SoponSaenkaew/fall-detection/docs/assembly_small.jpg

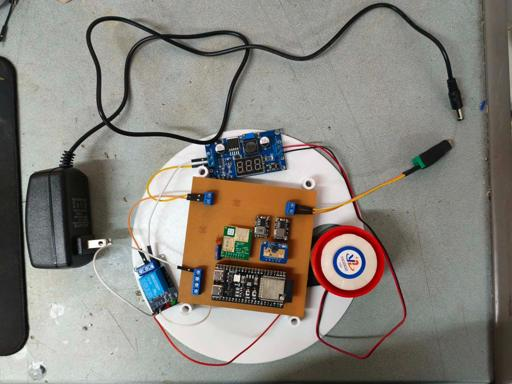
docs/assembly_small.jpg
