SoponSaenkaew/fall-detection/docs/3D print/Brilliant Amberis (3).stl

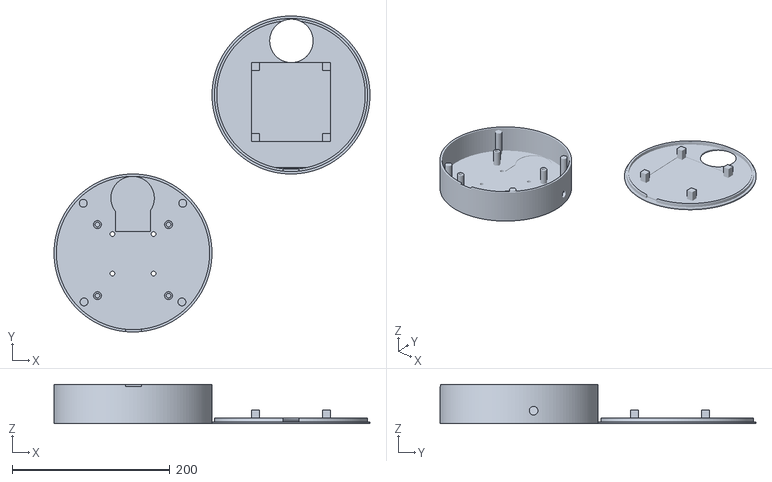
[picture p2: CAD file, 2026-09-25]
docs/3D print/Brilliant Amberis (3).stl
400.0 x 400.0 x 50.0
