SoponSaenkaew/fall-detection/docs/project_guide.html

60 GHz mmWave Radar & Cloud Native IoT Architecture

# ระบบตรวจจับการล้มอัจฉริยะในห้องน้ำ SafeBathroom IoT System Master Guide

คู่มือเจาะลึก 10 มิติสำคัญ: สถาปัตยกรรมระดับฮาร์ดแวร์, ตาราง Pinout, โปรโตคอลเรดาร์ LD6002C, กลไก Sensor Fusion, MQTT LWT, โครงสร้างฐานข้อมูล PostgreSQL, โค้ดหลังบ้าน Go, หน้าบ้าน Next.js, คลาวด์ Azure VM และคลังคำถามกรรมการ

ชิปประมวลผล

ESP32-S3

Xtensa Dual-core 240MHz + NVS

เรดาร์คลื่นมิลลิเมตร

60 GHz & 24 GHz

LD6002C (FMCW) + LD2410C

เซิร์ฟเวอร์คลาวด์

Go + Azure VM

Docker + Mosquitto + Postgres

ระบบเตือนภัย

LINE & Siren

Silent Timer + Web Audio API

สารบัญหัวข้อ (10 ส่วน)

1

## ภาพรวมสถาปัตยกรรมระดับระบบ (System Architecture & Pipeline)

ที่มาของปัญหา ความสำคัญ และการไหลของข้อมูลตั้งแต่เซนเซอร์จนถึงผู้ดูแลระบบ

### ทำไมต้องเป็น "ห้องน้ำ" และทำไมเทคโนโลยีอื่นจึงล้มเหลว?

ข้อจำกัดของเทคโนโลยีเดิม

- • กล้องวงจรปิด (Cameras): ผิดกฎหมายคุ้มครองข้อมูลส่วนบุคคล (PDPA/Privacy) อย่างร้ายแรง จึงไม่สามารถติดในห้องน้ำได้เด็ดขาด
- • เซนเซอร์ความร้อน PIR: ตรวจจับได้เฉพาะคนเคลื่อนไหว หากคนล้มหมดสติหรือนอนนิ่ง PIR จะตีความว่า "ห้องว่าง" ทันที
- • นาฬิกา/ปุ่มกดฉุกเฉิน (Wearables): ผู้สูงอายุมักถอดออกก่อนอาบน้ำ และหากล้มจนหมดสติจะไม่สามารถกดปุ่มได้
- • ความชื้นและละอองน้ำ: อุปกรณ์เลนส์ออปติคอลมักมีฝ้าไอน้ำเกาะ ทำให้จับภาพไม่ได้

จุดเด่นของ SafeBathroom IoT

- • ความเป็นส่วนตัว 100%: คลื่นวิทยุเรดาร์วัดแค่ค่าสะท้อนสนามคลื่นแม่เหล็กไฟฟ้า (Point Cloud) ไม่มีภาพถ่ายแม้แต่พิกเซลเดียว
- • ตรวจจับคนหมดสติได้: มีคลื่น 24GHz ตรวจจับการกระเพื่อมของหน้าอกจากการหายใจ (Micro-motion)
- • ทนทานต่อสภาพแวดล้อม: คลื่น 60GHz ทะลุไอน้ำ ละอองน้ำ และทำงานได้แม้ปิดไฟมืดสนิท 0 Lux
- • Zero-touch: ติดตั้งบนเพดาน ผู้ใช้งานไม่ต้องพกพาอุปกรณ์ ไม่ต้องกดปุ่มใดๆ

สถาปัตยกรรมการเชื่อมต่อแบบ End-to-End Pipeline Real-time < 500ms

1. Sensing

LD6002C + LD2410C

เรดาร์ 60GHz + 24GHz บนเพดานห้องน้ำ

2. Edge Processing

ESP32-S3 Firmware

Sensor Fusion, จับเวลาอยู่นาน, ไซเรน

3. Transport Layer

MQTT + LWT

Mosquitto Broker บน Azure Docker

4. Cloud Engine

Go Backend (Gin)

บันทึก PostgreSQL, ยิง LINE Notify

5. Frontend Client

Next.js Dashboard

WebSocket Live Feed + เสียงไซเรนเตือน

2

## วงจรฮาร์ดแวร์และตาราง Pinout (Hardware Schematics & Pinout)

รายละเอียดขา GPIO แรงดันไฟฟ้า วงจรรีเลย์ และปุ่มจำลองบนบอร์ด ESP32-S3

ESP32 Pin | อุปกรณ์ที่เชื่อมต่อ | ชนิดสัญญาณ (Mode) | โปรโตคอล / ระดับลอจิก | หน้าที่การทำงาน
GPIO 18 | HLK-LD6002C (TX Pin) | Digital INPUT (RX0) | UART 115200 Baud | รับ Binary Frames ตรวจจับคนหกล้มและพิกัด
GPIO 17 | HLK-LD6002C (RX Pin) | Digital OUTPUT (TX0) | UART 115200 Baud | ส่งคำสั่ง Config / Reset สู่โมดูล LD6002C
GPIO 16 | HLK-LD2410C (OUT Pin) | INPUT_PULLDOWN | Active HIGH (3.3V) | ตรวจสอบการมีคนอยู่ในห้อง (HIGH=มีคน, LOW=ห้องว่าง)
GPIO 15 | Relay Module + Buzzer | OUTPUT | Active LOW (0V=ดัง) | ขับเสียงไซเรนฉุกเฉินเมื่อเกิดเหตุล้ม (LOW=สับสวิตช์)
GPIO 48 | WS2812B RGB LED | OUTPUT | NeoPixel 800kHz Single-wire | ไฟบอกสถานะ (เขียว=ว่าง, น้ำเงิน=มีคน, แดง=ล้ม, ส้ม=อยู่นาน)
GPIO 4 | Button: Sim Fall | INPUT_PULLUP | Active LOW (กดปุ่ม) | ปุ่มทดสอบบนบอร์ด: บังคับเกิดเหตุล้มทันทีเพื่อสาธิต
GPIO 5 | Button: Sim Enter | INPUT_PULLUP | Active LOW (กดปุ่ม) | ปุ่มทดสอบบนบอร์ด: บังคับสถานะมีคนเข้าห้องน้ำ
GPIO 1 | Button: Sim Exit | INPUT_PULLUP | Active LOW (กดปุ่ม) | ปุ่มทดสอบบนบอร์ด: บังคับสถานะคนออกจากห้องน้ำ
5V & GND | Power Supply Rails | Power Input | DC 5V / 2A Step-Down | จ่ายไฟเลี้ยงเรดาร์ LD6002C, โมดูลรีเลย์ไซเรน และบอร์ด ESP32

#### ระบบจ่ายไฟและความเสถียร (Power Architecture)

เซนเซอร์เรดาร์ 60 GHz (LD6002C) มีช่วงพีคกระแสส่งคลื่นความถี่สูงถึง 400-500 mA การต่อไฟตรงจากขา 3.3V ของบอร์ดไมโครคอนโทรลเลอร์จะทำให้เกิดแรงดันตก (Voltage Drop) และทำให้บอร์ดรีสตาร์ทตัวเอง เราจึงใช้แหล่งจ่ายไฟ 5V 2A ภายนอก แยกรางจ่ายให้กับเรดาร์และรีเลย์โดยตรง พร้อมต่อ C ฟิลเตอร์ 100uF คร่อม VCC/GND

#### วงจรรีเลย์ Active LOW สำหรับไซเรน

โมดูลรีเลย์ที่ใช้เป็นแบบ Active LOW กล่าวคือเมื่อขา GPIO 15 จ่ายแรงดัน 0V (LOW) ทรานซิสเตอร์ออปโต้จะนำกระแส ทำให้ขดลวดรีเลย์สับสวิตช์ส่งเสียงไซเรน และเมื่อจ่าย HIGH (3.3V) รีเลย์จะตัดวงจร ดังนั้นในโค้ดฟังก์ชัน setup() จึงต้องสั่ง digitalWrite(RELAY_BUZZER_PIN, HIGH) ก่อนเสมอ เพื่อป้องกันเสียงดังรบกวนขณะเปิดเครื่อง

3

## เจาะลึกโปรโตคอลเรดาร์ (Radar Protocols: LD6002C & LD2410C)

โครงสร้าง Binary Frame การคำนวณ Checksum และการประมวลผลข้อมูลระดับไบต์

### HLK-LD6002C โครงสร้างเฟรมข้อมูล Binary (UART 115200 Baudrate)

เรดาร์ส่งข้อมูลเป็น Binary Stream ความเร็วสูง โดยแต่ละแพ็กเก็ตมีความยาวแปรผัน แต่มีโครงสร้างคงที่ 8 ไบต์แรก:

SOF (1B)

0x01

Start Byte

ID (1B)

0xXX

Radar ID

LEN (2B)

0x00 0x08

Length (Little)

TYPE (2B)

0x0E02

Fall Event

PAYLOAD (N)

0x01 ...

State / Point

CHKSUM (1B)

~XOR

Bitwise Invert

รหัสชนิดข้อความ (Message Types) ตามคู่มือทางการ HLK-LD6002C Communication Protocol: TinyFrame Standard

0x0E02 : MSG_IND_FALL_STATUS Radar → MCU

รายงานผลตรวจจับการล้ม: Payload 1 ไบต์ (0x01 = หกล้ม, 0x00 = ท่าทางปกติ)

0x0E0C : MSG_IND_FALL_SET_ALARM_AREA Two-way (16 Bytes)

กำหนดขอบเขตพื้นที่เตือนภัย / ขนาดห้อง: ส่ง Float 4 ค่า (rect_XL ซ้าย, rect_XR ขวา, rect_ZF หน้า, rect_ZB หลัง)

0x0E04 : MSG_IND_FALL_SET_HIGH Two-way (4 Bytes)

ตั้งค่าความสูงติดตั้งเรดาร์จากพื้น: ส่ง Float 4 ไบต์ (ระยะ 1.0 - 5.0 เมตร เช่น 2.2m) และเรดาร์ตอบรับ ACK (0=fail, 1=success)

0x0E08 : MSG_IND_FALL_SET_THRESHOLD Two-way (4 Bytes)

ตั้งค่าเกณฑ์ความสูงตัดสินการล้ม (Fall Threshold): Float 4 ไบต์ (ค่าเริ่มต้น 0.6m หรือปรับตั้ง 0.5m) และเรดาร์ตอบรับผล

0x0E0E : MSG_TARGET_HEIGHT Radar → MCU (Live)

รายงานระดับความสูงสดของเป้าหมาย: เรดาร์ส่งระดับความสูงของเป้าหมายจากพื้นแบบอัตโนมัติ (Float 4 ไบต์)

0x0E06 / 0x0E0A : GET_HIGH & SENSITIVITY Config Commands

0x0E06 อ่านค่าพารามิเตอร์ทั้งหมด 28 ไบต์ | 0x0E0A ตั้งค่าความไวตรวจจับ (3~10 เฟรม)

โค้ดการคำนวณ Checksum และถอดรหัสใน RadarSensors.h: ESP32 Firmware

// สูตรคำนวณ Checksum ของ LD6002C: Bitwise Invert of XOR sum (~XOR)
uint8_t calcXor = 0;
for (int i = 0; i < frameLen - 1; i++) {
    calcXor ^= buffer[i];
}
uint8_t expectedChecksum = ~calcXor; // กลับบิตทั้งหมด

if (buffer[frameLen - 1] == expectedChecksum) {
    uint16_t msgType = (buffer[4] << 8) | buffer[5];
    if (msgType == 0x0E02) { // เฟรมตรวจจับการล้ม
        uint8_t isFall = buffer[6]; // ไบต์แรกของ Payload
        if (isFall == 0x01 && current_event != "exit") {
            triggerFallEvent(); // ยืนยันการล้ม (Sensor Fusion Guard)
        }
    }
}

4

## ตรรกะการผสานข้อมูลเซนเซอร์ (Sensor Fusion & Edge State Machine)

อัลกอริทึมกรอง False Alarm, ระบบฟื้นตัวอัตโนมัติ (Recovery) และหน่วยความจำ NVS Flash

จุดอ่อนของระบบที่ใช้เรดาร์ตัวเดียวคือ False Alarm จากสิ่งของตกหล่น เช่น หากขวดแชมพูหรือผ้าเช็ดตัวร่วงหล่นลงพื้น คลื่นความถี่ 60GHz อาจตีความว่าเกิดการตกกระทบของมวล (Fall) ดังนั้นเราจึงออกแบบกลไก Sensor Fusion ข้ามย่านความถี่:

#### 1. Empty Room Guard

แม้ LD6002C จะยิงเฟรม 0x0E02 (Fall) ออกมา แต่เฟิร์มแวร์จะไม่ประมวลผล หาก LD2410C รายงานว่าห้องว่าง (ขา OUT เป็น LOW) ทำให้ตัดปัญหาสิ่งของตกในห้องน้ำที่ไม่มีคนได้อย่างเด็ดขาด 100%

#### 2. Fall Recovery & Failsafe

Auto Recovery: หากคนล้มแล้วพยุงตัวลุกขึ้นยืนทรงตัวได้เกิน 2.5 วินาที ระบบจะปรับจาก fall คืนสู่ enter
Failsafe: หากค้างสถานะล้มแต่คนเดินออกไปแล้วเกิน 20 วินาที จะตัดเข้า exit

#### 3. Prolonged Stay (อยู่นาน)

เมื่อมีคนเข้าห้องน้ำ ตัวนับเวลาจะเริ่มเดิน หากอยู่ต่อเนื่องเกินเวลาที่ตั้งไว้ (ดีฟอลต์ 30 นาที) บอร์ดจะส่งเตือน prolonged_stay โดยปิดเสียงไซเรน (Silent Alert) เพื่อเคารพความเป็นส่วนตัวและไม่รบกวนผู้สูงอายุ

State (สถานะ) | เงื่อนไขเซนเซอร์ | ไฟ LED (WS2812B) | รีเลย์ไซเรน (Relay) | การแจ้งเตือนทาง LINE
exit ห้องว่าง | LD2410 OUT = LOW (> 5 วินาที) | 🟢 เขียวนิ่ง (Green) | OFF (ขา 15 = HIGH) | - ไม่ส่ง -
enter มีคนใช้งาน | LD2410 OUT = HIGH (ตรวจพบคน) | 🔵 ฟ้านิ่ง (Blue) | OFF (ขา 15 = HIGH) | - ไม่ส่ง -
fall คนล้มฉุกเฉิน! | มีคน + LD6002C Frame 0x0E02 | 🔴 แดงกะพริบถี่ (Blink Red) | 🔊 ON ดังต่อเนื่อง (ขา 15 = LOW) | 🚨 แจ้งเหตุฉุกเฉินทันที!
prolonged_stay อยู่นานเกิน | สถานะ enter ต่อเนื่อง ≥ timeout | 🟠 ส้มนิ่ง (Orange) | OFF (ปิดเสียงเพื่อความเป็นส่วนตัว) | ⏳ ส่งแจ้งเตือนเคาะประตูห้อง
offline ขาดการเชื่อมต่อ | MQTT Heartbeat ขาด / ไฟดับ (LWT) | - (ตัวเครื่องดับ) | - | การ์ดแสดงสถานะสีเทาบนแดชบอร์ด

การบันทึกค่าลง Non-Volatile Storage (NVS Flash Memory)

เมื่อผู้ดูแลตั้งค่าความสูงเพดาน (Mount Height) หรือเวลาเตือนอยู่นาน (Stay Timeout) จากหน้าแดชบอร์ด ข้อมูลจะถูกส่งลงบอร์ดผ่าน MQTT และเซฟลงชิป ESP32 NVS Flash ทันที เมื่อไฟดับหรือดึงปลั๊กออก ค่าคอนฟิกเหล่านี้จะไม่สูญหาย และบอร์ดจะนำมาใช้ทำงานต่อได้ทันทีที่ไฟมา

5

## โปรโตคอลการสื่อสาร MQTT, JSON Payload และกลไก LWT

การออกแบบ Topic, โครงสร้างข้อมูล JSON และการตรวจจับเครื่องดับฉับพลันด้วยพินัยกรรม

#### โครงสร้าง Topic ในระบบ

- sensor/events
  บอร์ดส่ง Event ขึ้น Backend (fall, enter, exit, stay)
- sensor/settings
  Backend ส่งคำสั่งปรับพารามิเตอร์ลงบอร์ด (Remote Config)

การใช้ MQTT QoS 0 ทำให้การส่งข้อมูลมี Overhead ต่ำเป็นพิเศษ (ไม่เกิน 200 ไบต์ต่อแพ็กเก็ต) รองรับการรับส่งผ่านเครือข่าย Wi-Fi ที่สัญญาณอ่อนในมุมอับของห้องน้ำได้ดี

#### ตัวอย่าง JSON Payload มาตรฐาน

{
  "device_id": "B1_R101",
  "type": "event",
  "name": "fall",
  "value": "ตรวจพบคนล้ม (เรดาร์)",
  "metadata": "{\"x\":1.2,\"y\":2.4,\"z\":0.3}"
}

#### ขั้นตอนการทำงานของ MQTT Last Will & Testament (LWT)

ขั้นตอนที่ 1

ฝากพินัยกรรม

ตอนบอร์ด Connect ระบุ Will Payload เป็น {"name":"offline"}

ขั้นตอนที่ 2

ส่ง Heartbeat ปกติ

บอร์ดแลกเปลี่ยน Ping กับ Mosquitto ตลอดเวลา

ขั้นตอนที่ 3

ไฟดับ / เครื่องดับ

TCP Socket ขาดสะบั้น โดยไม่มีการส่งแพ็กเก็ต DISCONNECT

ขั้นตอนที่ 4

โบรกเกอร์เปิดพินัยกรรม

Mosquitto เผยแพร่ข้อความ offline ไปให้ Go Backend ทันที

6

## สถาปัตยกรรมฐานข้อมูลเชิงสัมพันธ์และสกีม่า (Database Schemas & Architecture Rationale)

โครงสร้างสกีม่าทั้ง 6 ตาราง, ความหมายทุกคอลัมน์, ข้อกำหนดความสมบูรณ์ของข้อมูล และเหตุผลเชิงวิศวกรรมในการออกแบบ

### Azure Database for PostgreSQL (Flexible Server)

ระบบจัดการฐานข้อมูลเชิงสัมพันธ์ระดับ Enterprise: Flexible Server B1ms (1 vCPU, 2 GiB RAM), Port 5432, บังคับใช้ SSL Mode (sslmode=require)

PostgreSQL 15+ GORM AutoMigrate Native JSONB Soft Delete Enabled

#### 1. แผนผังความสัมพันธ์ข้อมูลระดับภาพรวม (Entity-Relationship Model)

Primary Parent

👤 USERS

ผู้ดูแลระบบ/ผู้ใช้

PK: id

1 : N from Users

🏢 GROUPS

อาคาร / วอร์ด / โซน

PK: id | FK: user_id

1 : N from Groups

🚪 DEVICES

ห้องน้ำ / กล่องเซนเซอร์

PK: id | FK: group_id

1 : N from Devices

📜 DEVICE_EVENTS

ประวัติเหตุการณ์ฉุกเฉิน

PK: id | FK: device_id

DEVICES (1) ➔ DEVICE_SETTINGS (1) 1:1 Strict

แยกพารามิเตอร์ฮาร์ดแวร์เรดาร์ (เกณฑ์ล้ม, ความสูง, เวลาอยู่นาน) ออกจากสถานะสด

GROUPS (1) ➔ NOTIFICATION_CONFIGS (N) 1:N Flexible

ผูกช่องทางเตือนภัย LINE Bot / Webhook เข้ากับอาคารหรือวอร์ดโดยตรง

#### 2. สกีม่าของระบบฉบับสมบูรณ์ (Complete Schema Definitions)

PostgreSQL DDL Go GORM Structs

-- =========================================================================
-- 1. ตาราง users: เก็บข้อมูลบัญชีผู้ดูแลระบบ (Admin Authentication)
-- =========================================================================
CREATE TABLE users (
    id          BIGSERIAL PRIMARY KEY,
    created_at  TIMESTAMPTZ DEFAULT CURRENT_TIMESTAMP,
    updated_at  TIMESTAMPTZ DEFAULT CURRENT_TIMESTAMP,
    deleted_at  TIMESTAMPTZ,                           -- สำหรับ GORM Soft Delete
    username    VARCHAR(255) NOT NULL UNIQUE,
    email       VARCHAR(255) NOT NULL UNIQUE,
    password    VARCHAR(255) NOT NULL,                  -- เก็บรหัสผ่านแบบ Bcrypt Hash
    role        VARCHAR(50)  DEFAULT 'admin'
);
CREATE INDEX idx_users_deleted_at ON users(deleted_at);

-- =========================================================================
-- 2. ตาราง groups: โครงสร้างอาคาร / แผนก / โซนที่ติดตั้ง (Multi-tenancy)
-- =========================================================================
CREATE TABLE groups (
    id          BIGSERIAL PRIMARY KEY,
    created_at  TIMESTAMPTZ DEFAULT CURRENT_TIMESTAMP,
    updated_at  TIMESTAMPTZ DEFAULT CURRENT_TIMESTAMP,
    deleted_at  TIMESTAMPTZ,
    name        VARCHAR(255) NOT NULL,                 -- ชื่ออาคาร เช่น "อาคารผู้ป่วยพิเศษ 1"
    description TEXT,                                  -- คำบรรยายสถานที่
    address     TEXT,
    user_id     BIGINT REFERENCES users(id) ON DELETE SET NULL
);
CREATE INDEX idx_groups_deleted_at ON groups(deleted_at);
CREATE INDEX idx_groups_user_id ON groups(user_id);

-- =========================================================================
-- 3. ตาราง devices: กล่องเซนเซอร์ประจำห้องน้ำแต่ละห้อง (Hardware Registration)
-- =========================================================================
CREATE TABLE devices (
    id                    BIGSERIAL PRIMARY KEY,
    created_at            TIMESTAMPTZ DEFAULT CURRENT_TIMESTAMP,
    updated_at            TIMESTAMPTZ DEFAULT CURRENT_TIMESTAMP,
    deleted_at            TIMESTAMPTZ,
    device_id             VARCHAR(100) NOT NULL UNIQUE,   -- Hardware ID เช่น "B1_R101"
    name                  VARCHAR(255),                   -- ชื่อห้อง เช่น "ห้องน้ำชาย 101"
    room_number           VARCHAR(50),
    status                VARCHAR(50) DEFAULT 'offline', -- "online" หรือ "offline"
    latest_event          VARCHAR(50),                    -- "fall", "enter", "exit", "prolonged_stay"
    latest_event_metadata TEXT,                           -- ข้อมูลล่าสุดในรูปแบบ JSON String
    group_id              BIGINT REFERENCES groups(id) ON DELETE CASCADE
);
CREATE INDEX idx_devices_deleted_at ON devices(deleted_at);
CREATE INDEX idx_devices_device_id ON devices(device_id);
CREATE INDEX idx_devices_group_id ON devices(group_id);

-- =========================================================================
-- 4. ตาราง device_events: เก็บบันทึกประวัติทุกเหตุการณ์ (Event Logging & Audit)
-- =========================================================================
CREATE TABLE device_events (
    id              BIGSERIAL PRIMARY KEY,
    created_at      TIMESTAMPTZ DEFAULT CURRENT_TIMESTAMP,
    updated_at      TIMESTAMPTZ DEFAULT CURRENT_TIMESTAMP,
    deleted_at      TIMESTAMPTZ,
    device_id       BIGINT NOT NULL REFERENCES devices(id) ON DELETE CASCADE,
    type            VARCHAR(50) NOT NULL,              -- "event" (ล้ม/เข้า/ออก) หรือ "status" (เน็ต)
    name            VARCHAR(50) NOT NULL,              -- "fall", "prolonged_stay", "enter", "exit"
    value           TEXT,                              -- คำอธิบายเหตุการณ์ เช่น "ตรวจพบคนล้ม"
    metadata        JSONB,                             -- พิกัด X, Y, Z หรือ Payload ยืดหยุ่น
    status          VARCHAR(50) DEFAULT 'pending',  -- "pending", "resolved", "false_alarm", "normal"
    resolved_at     TIMESTAMPTZ,                       -- เวลาที่เจ้าหน้าที่กดบันทึกผลการเข้าช่วย
    resolved_by     VARCHAR(255),                      -- ชื่อเจ้าหน้าที่/พยาบาลเวร
    resolution_note TEXT                               -- บันทึกอาการ เช่น "นำส่งห้องฉุกเฉินแล้ว"
);
CREATE INDEX idx_device_events_deleted_at ON device_events(deleted_at);
CREATE INDEX idx_device_events_device_id ON device_events(device_id);
CREATE INDEX idx_device_events_status ON device_events(status);
CREATE INDEX idx_device_events_created_at ON device_events(created_at DESC);

-- =========================================================================
-- 5. ตาราง device_settings: พารามิเตอร์ฮาร์ดแวร์เรดาร์ (1:1 กับ Devices)
-- =========================================================================
CREATE TABLE device_settings (
    id                   BIGSERIAL PRIMARY KEY,
    created_at           TIMESTAMPTZ DEFAULT CURRENT_TIMESTAMP,
    updated_at           TIMESTAMPTZ DEFAULT CURRENT_TIMESTAMP,
    deleted_at           TIMESTAMPTZ,
    device_id            VARCHAR(100) NOT NULL UNIQUE REFERENCES devices(device_id) ON DELETE CASCADE,
    fall_threshold       DOUBLE PRECISION DEFAULT 0.5,     -- เกณฑ์ตัดสินล้ม (เมตร)
    mount_height         DOUBLE PRECISION DEFAULT 2.0,     -- ความสูงติดตั้งเพดาน (เมตร)
    room_width           DOUBLE PRECISION DEFAULT 4.0,     -- ความกว้างห้อง (เมตร)
    room_length          DOUBLE PRECISION DEFAULT 4.0,     -- ความยาวห้อง (เมตร)
    stay_timeout_minutes DOUBLE PRECISION DEFAULT 30.0    -- เวลาอยู่นานเกินเตือนเงียบ (นาที)
);
CREATE INDEX idx_device_settings_device_id ON device_settings(device_id);

-- =========================================================================
-- 6. ตาราง notification_configs: ช่องทางแจ้งเตือนฉุกเฉิน (1:N กับ Groups)
-- =========================================================================
CREATE TABLE notification_configs (
    id            BIGSERIAL PRIMARY KEY,
    created_at    TIMESTAMPTZ DEFAULT CURRENT_TIMESTAMP,
    updated_at    TIMESTAMPTZ DEFAULT CURRENT_TIMESTAMP,
    deleted_at    TIMESTAMPTZ,
    group_id      BIGINT REFERENCES groups(id) ON DELETE CASCADE,
    type          VARCHAR(50) NOT NULL DEFAULT 'line', -- "line", "discord", "webhook"
    target_url    TEXT,                                     -- Endpoint ปลายทาง Webhook
    line_token    TEXT,                                     -- LINE Channel Access Token
    line_group_id VARCHAR(100),                             -- Group ID แชทพยาบาล
    enabled       BOOLEAN DEFAULT TRUE
);
CREATE INDEX idx_notification_configs_group_id ON notification_configs(group_id);

// backend/internal/user/model.go & backend/internal/iot/model.go
package iot

import (
    "time"
    "gorm.io/gorm"
)

// 1. User: ผู้ดูแลระบบ
type User struct {
    gorm.Model
    Email    string  `gorm:"unique;not null" json:"email"`
    Username string  `gorm:"unique;not null" json:"username"`
    Password string  `gorm:"not null" json:"-"` // ซ่อน password จาก JSON Response
    Role     string  `gorm:"default:'admin'" json:"role"`
    Groups   []Group `gorm:"foreignKey:UserID" json:"groups,omitempty"`
}

// 2. Group: อาคาร / โซน
type Group struct {
    gorm.Model
    Name                string               `gorm:"not null" json:"name"`
    Description         string               `json:"description"`
    Address             string               `json:"address"`
    UserID              uint                 `json:"user_id"`
    Devices             []Device             `gorm:"foreignKey:GroupID" json:"devices"`
    NotificationConfigs []NotificationConfig `gorm:"foreignKey:GroupID" json:"notification_configs"`
}

// 3. Device: ห้องน้ำแต่ละจุด
type Device struct {
    gorm.Model
    DeviceID            string        `gorm:"unique;not null" json:"device_id"`
    Name                string        `json:"name"`
    RoomNumber          string        `json:"room_number"`
    Status              string        `gorm:"default:'offline'" json:"status"`
    LatestEvent         string        `json:"latest_event"`
    LatestEventMetadata string        `json:"latest_event_metadata"`
    GroupID             uint          `json:"group_id"`
    Settings            DeviceSetting `gorm:"foreignKey:DeviceID;references:DeviceID" json:"settings"`
    Events              []DeviceEvent `gorm:"foreignKey:DeviceID" json:"events,omitempty"`
}

// 4. DeviceEvent: ประวัติเหตุการณ์
type DeviceEvent struct {
    gorm.Model
    DeviceID       uint       `gorm:"index;not null" json:"device_id"`
    Type           string     `gorm:"index;not null" json:"type"`
    Name           string     `gorm:"index;not null" json:"name"`
    Value          string     `json:"value"`
    Metadata       string     `gorm:"type:jsonb" json:"metadata"` // เก็บพิกัด/ข้อมูลเทคนิคเป็น JSONB
    Status         string     `gorm:"default:'pending';index" json:"status"`
    ResolvedAt     *time.Time `json:"resolved_at"`
    ResolvedBy     string     `json:"resolved_by"`
    ResolutionNote string     `json:"resolution_note"`
}

// 5. DeviceSetting: พารามิเตอร์เรดาร์
type DeviceSetting struct {
    gorm.Model
    DeviceID           string  `gorm:"uniqueIndex;not null" json:"device_id"`
    FallThreshold      float64 `gorm:"default:0.5" json:"fall_threshold"`
    MountHeight        float64 `gorm:"default:2.0" json:"mount_height"`
    RoomWidth          float64 `gorm:"default:4.0" json:"room_width"`
    RoomLength         float64 `gorm:"default:4.0" json:"room_length"`
    StayTimeoutMinutes float64 `gorm:"default:30.0" json:"stay_timeout_minutes"`
}

// 6. NotificationConfig: ช่องทางแจ้งเตือน LINE/Webhook
type NotificationConfig struct {
    gorm.Model
    GroupID     uint   `json:"group_id"`
    Type        string `json:"type"`
    TargetURL   string `json:"target_url"`
    LineToken   string `json:"line_token"`
    LineGroupID string `json:"line_group_id"`
    Enabled     bool   `gorm:"default:true" json:"enabled"`
}

#### 3. เจาะลึกความหมายและเหตุผลของทั้ง 6 ตาราง (Table Semantics & Design Rationales)

Table: users บัญชีผู้ดูแลระบบและการพิสูจน์ตัวตน

Engine: PostgreSQL / Authentication Layer

Field | Type & Constraints | ความหมายของข้อมูล | เหตุผลในการออกแบบ (Rationale)
id | BIGSERIAL (PK) | รหัสอ้างอิงผู้ใช้งานในระบบแบบ Auto-increment | ใช้ Surrogate Key ชนิด 64-bit Integer เพื่อประสิทธิภาพการ Index สูงสุดและประหยัดเนื้อที่ Foreign Key
username, email | VARCHAR(255) UNIQUE NOT NULL | ชื่อบัญชีและอีเมลสำหรับล็อกอินเข้า Web Dashboard | สร้าง B-Tree Unique Index เพื่อป้องกันบัญชีซ้ำซ้อนและเร่งความเร็วในการค้นหาตอน Login (O(log n))
password | VARCHAR(255) NOT NULL | รหัสผ่านที่เข้ารหัสแล้ว (Bcrypt Hash) | ห้ามเก็บ Plain Text เด็ดขาดตามมาตรฐานความปลอดภัย OWASP ใช้ Bcrypt ที่มี Salt ในตัว ป้องกัน Rainbow Table Attack
deleted_at | TIMESTAMPTZ INDEX | วันเวลาที่ลบบัญชี (ถ้าไม่ถูกลบจะมีค่าเป็น NULL) | Soft Delete เพื่อเก็บประวัติการตรวจสอบย้อนหลัง (Audit Log) ไม่ให้ข้อมูลอาคารหรืออุปกรณ์ที่เคยสร้างไว้หลุดความสัมพันธ์

Table: groups กลุ่มอาคาร / วอร์ดผู้ป่วย / โซนพื้นที่

Relation: BelongsTo(User), HasMany(Devices, NotificationConfigs)

Field | Type & Constraints | ความหมายของข้อมูล | เหตุผลในการออกแบบ (Rationale)
id | BIGSERIAL (PK) | รหัสประจำกลุ่มอาคาร | ใช้เชื่อมโยง Foreign Key ไปยังตาราง `devices` และ `notification_configs`
name | VARCHAR(255) NOT NULL | ชื่ออาคารหรือโซน เช่น "อาคารเฉลิมพระเกียรติ ชั้น 3" | จำเป็นต้องระบุ (NOT NULL) เพื่อนำไปแสดงผลบน Header ข้อความแจ้งเตือนทาง LINE ให้เจ้าหน้าที่ทราบพิกัดทันที
user_id | BIGINT FK (ON DELETE SET NULL) | รหัสผู้ดูแลระบบที่สร้างกลุ่มนี้ | ออกแบบเพื่อรองรับ Multi-tenancy หากบัญชีผู้ใช้ถูกลบ กลุ่มอาคารยังคงอยู่ให้ผู้ดูแลท่านอื่นสวมสิทธิ์ดูแลต่อได้

ทำไมต้องมีตาราง Groups? เพราะในโรงพยาบาลหรือศูนย์ดูแลผู้สูงอายุจริง การบริหารไม่ได้ดูเป็นห้องน้ำเดี่ยวๆ แต่ดูเป็น "วอร์ด" หรือ "ตึก" การมีตาราง Groups ทำให้สามารถสเกลระบบรองรับได้นับร้อยห้องน้ำโดยแบ่งกลุ่มหน้า Dashboard ได้อย่างเป็นระเบียบ

Table: devices ข้อมูลกล่องเซนเซอร์ประจำห้องน้ำแต่ละห้อง

Relation: BelongsTo(Group), HasOne(DeviceSetting), HasMany(Events)

Field | Type & Constraints | ความหมายของข้อมูล | เหตุผลในการออกแบบ (Rationale)
id | BIGSERIAL (PK) | Surrogate Primary Key ภายในระบบ | ลดภาระ Foreign Key Cascade และการ Re-index เมื่อเทียบกับการใช้ String Hardware ID เป็น PK โดยตรง
device_id | VARCHAR(100) UNIQUE NOT NULL | รหัส Hardware ID ที่ผูกกับตัวเครื่อง เช่น "B1_R101" | ทำหน้าที่เป็น Natural Identifier สำหรับอุปกรณ์ IoT ในการส่ง MQTT Topic / Payload เข้ามาจับคู่ข้อมูล
status | VARCHAR(50) DEFAULT 'offline' | สถานะการเชื่อมต่อ: "online" หรือ "offline" | อัปเดตผ่านกลไก MQTT LWT และ Heartbeat เพื่อให้หน้าเว็บเปลี่ยนสีการ์ดห้องน้ำเป็นสีเทาทันทีที่ไฟดับ
latest_event | VARCHAR(50) | เหตุการณ์ล่าสุด: "fall", "enter", "exit", "prolonged_stay" | เก็บ Cached State ล่าสุดไว้ที่ตารางแม่ เพื่อให้หน้าจอแสดงผลไม่ต้อง Query หา MAX(created_at) จากตาราง events ทุกครั้ง
group_id | BIGINT FK (ON DELETE CASCADE) | สังกัดกลุ่มอาคารใด | จัดหมวดหมู่ห้องน้ำเข้าสู่อาคาร และใช้ Cascade Delete ลบห้องน้ำอัตโนมัติหากกลุ่มอาหารถูกลบอย่างถาวร

Table: device_events บันทึกประวัติเหตุการณ์ฉุกเฉินและกระบวนการเข้าช่วยเหลือ (Audit Log)

Append-Heavy Table / Timeseries Pattern

Field | Type & Constraints | ความหมายของข้อมูล | เหตุผลในการออกแบบ (Rationale)
device_id | BIGINT NOT NULL (INDEX, FK) | เชื่อมโยงไปยัง `devices.id` เจ้าของเหตุการณ์ | สร้าง Foreign Key Index เพื่อเร่งความเร็วในการคิวรีประวัติเฉพาะห้อง เช่น `WHERE device_id = 10`
type, name | VARCHAR(50) (INDEXED) | Type: "event" | "status" Name: "fall", "prolonged_stay", "online", "offline" | แยกหมวดหมู่เพื่อการฟิลเตอร์บนหน้าเว็บ `/history` และทำสถิติความถี่ของการล้มเทียบกับการเข้าห้องน้ำปกติ
metadata | JSONB | ข้อมูลทางเทคนิคเสริม เช่น พิกัด X, Y, Z หรือความเร็วตกกระทบ | ใช้ PostgreSQL JSONB ชนิดไบนารี เพื่อความยืดหยุ่นในการขยายฟีเจอร์ในอนาคตโดยไม่ต้องทำ ALTER TABLE เพิ่มคอลัมน์
status | VARCHAR(50) DEFAULT 'pending' (INDEX) | สถานะงาน: "pending", "resolved", "false_alarm", "normal" | ระบบควบคุมเหตุฉุกเฉิน (Triage System) หากเป็นเหตุคนล้มจะตั้งเป็น 'pending' บังคับให้เจ้าหน้าที่ต้องกดยืนยันการเข้าช่วย
resolved_at, resolved_by, resolution_note | TIMESTAMPTZ, VARCHAR, TEXT | วันเวลาที่ช่วยเหลือ, ชื่อเจ้าหน้าที่เวร, บันทึกการปฐมพยาบาล | Clinical Audit Trail: ใช้คำนวณ KPI Response Time (เวลาตอบสนอง) และเป็นหลักฐานทางการแพทย์และกฎหมาย

Table: device_settings พารามิเตอร์การตั้งค่าฮาร์ดแวร์เรดาร์ (1:1 กับ Devices)

Relation: HasOne(Device) via Unique device_id

Field | Type & Default | ความหมายของข้อมูล | เหตุผลในการออกแบบ (Rationale)
device_id | VARCHAR(100) UNIQUE FK | Hardware ID ที่ผูก 1:1 กับตาราง `devices` | รับประกันว่า 1 กล่องจะมีชุดพารามิเตอร์ปรับแต่งได้เพียง 1 ชุดเท่านั้น (Unique Constraint)
fall_threshold | DOUBLE (ดีฟอลต์ 0.5m) | เกณฑ์ตัดสินความสูงการล้ม (เมตร) | ส่งคำสั่ง `0x0E08` ลงเรดาร์ LD6002C เพื่อปรับตามความสูงของสุขภัณฑ์ในแต่ละห้องน้ำ
mount_height | DOUBLE (ดีฟอลต์ 2.0m) | ความสูงติดตั้งเรดาร์จากระดับพื้น (เมตร) | ส่งคำสั่ง `0x0E04` ลงเรดาร์เพื่อชดเชยระยะเพดาน ทำให้การคำนวณจุดล้มแม่นยำไม่คลาดเคลื่อน
room_width, room_length | DOUBLE (ดีฟอลต์ 4.0m) | ขนาดความกว้างและความยาวของห้องน้ำ (เมตร) | ส่งคำสั่ง `0x0E0C` (Alarm Area: XL, XR, ZF, ZB) บีบขอบเขตเรดาร์ไม่ให้คลื่นทะลุกำแพงไปจับห้องข้างเคียง
stay_timeout_minutes | DOUBLE (ดีฟอลต์ 30.0 นาที) | เกณฑ์ระยะเวลาเตือนเข้าห้องน้ำนานเกินกำหนด | ส่งลงบอร์ดเพื่อตั้งเวลา Prolonged Stay Timer ป้องกันคนหมดสติเงียบหรือท้องร่วงนานผิดปกติ

ทำไมต้องแยกตาราง Device Settings ออกจาก Devices (1:1 Normalization)? เพราะฟิลด์ใน `devices` (เช่น `status`, `latest_event`) มีอัตราการ Read/Write ถี่สูงมาก (High Frequency) ส่วนพารามิเตอร์ใน `device_settings` ช่างจะตั้งค่าเพียงครั้งเดียวตอนติดตั้ง (Low Frequency) การแยก 1:1 ช่วยให้ขนาดแถว (Row Size) ของ `devices` มีขนาดกะทัดรัด ประหยัด RAM ใน Buffer Pool และลดปัญหา Row-Level Locking ในฐานข้อมูล

Table: notification_configs ช่องทางการแจ้งเตือนภัยฉุกเฉินภายนอก (1:N กับ Groups)

Relation: BelongsTo(Group) via group_id

Field | Type & Constraints | ความหมายของข้อมูล | เหตุผลในการออกแบบ (Rationale)
group_id | BIGINT FK (ON DELETE CASCADE) | ผูกกับกลุ่มอาคารหรือวอร์ดผู้ป่วย | ส่งแจ้งเตือนตรงถึงกลุ่มเจ้าหน้าที่ที่ดูแลตึกนั้นๆ โดยไม่ต้องส่งรบกวนเจ้าหน้าที่ตึกอื่น
type | VARCHAR(50) DEFAULT 'line' | ประเภทช่องทาง: "line", "discord", "webhook" | รองรับการต่อขยายในอนาคต (Extensible Notifier) สามารถเชื่อมต่อระบบ Nurse Call หรือ HIS ของโรงพยาบาลได้
line_token, line_group_id | TEXT, VARCHAR(100) | Channel Access Token และ Group ID ของ LINE Messaging API | ยิงแจ้งเตือนเหตุฉุกเฉิน (Push Message) เข้า LINE กลุ่มพยาบาลเวรทันทีที่มีคนล้ม
enabled | BOOLEAN DEFAULT TRUE | สวิตช์เปิด/ปิดการแจ้งเตือนชั่วคราว | ช่วยให้ผู้ดูแลสามารถ Mute ปิดเสียงเตือนตอนซ่อมบำรุงระบบได้โดยไม่ต้องลบ Token ทิ้ง

#### 4. สรุปเหตุผลเชิงสถาปัตยกรรมสำหรับตอบกรรมการ (Architectural Decision Records - ADR)

1 ทำไมต้องแยก `device_settings` ออกจาก `devices` (1:1)?

ตอบ: เป็นการทำ Table Normalization แยกความถี่ในการเข้าถึงข้อมูล (Separation by Access Frequency) ตาราง `devices` ถูกอ่านและอัปเดตสถานะแบบ High Frequency (เมื่อมีคนเข้า/ออก หรือ Heartbeat ส่งมา) หากรวมพารามิเตอร์ขนาดห้องไว้ในตารางเดียว ทุกครั้งที่ Update จะทำให้ขนาดของ WAL Log และ Buffer Cache ใหญ่โดยเปล่าประโยชน์ การแยกตารางทำให้ `devices` ทำงานได้เร็วและไม่เกิด Row Lock ไปยังคอนฟิกครับ

2 ทำไมผูก `notification_configs` กับ `groups` แทนที่จะผูกกับ `devices`?

ตอบ: อิงตาม Operational Workflow ในความเป็นจริง ครับ เจ้าหน้าที่พยาบาลหรือรปภ. จะเข้าเวรดูแลเป็น "อาคาร" หรือ "วอร์ด" หากอาคารมี 20 ห้องน้ำ การผูกระดับห้องน้ำจะทำให้ต้องกรอก LINE Token ซ้ำถึง 20 ครั้ง และหากเปลี่ยนเวรต้องตามแก้ 20 จุด การผูกที่ระดับ Group ช่วยให้ตั้งค่าที่เดียวควบคุมได้ทั้งตึก และ 1 ตึกยังสามารถผูกได้หลายกลุ่มแชท (เช่น แชทพยาบาลเวร + แชทผู้บริหาร)

3 ทำไมต้องมีทั้ง Surrogate Key (`id`) และ Natural Key (`device_id`)?

ตอบ: เพื่อแก้ปัญหา Hardware Replacement Decoupling ครับ ในงาน IoT หากกล่องวงจรฮาร์ดแวร์ชำรุดแล้วช่างเปลี่ยนบอร์ดใหม่ที่มี Serial ใหม่ การใช้ Integer `id` เป็น Foreign Key อ้างอิงในตารางประวัติ (device_events) นับหมื่นรายการ ทำให้เราสามารถเปลี่ยน `device_id` หรืออัปเดตเครื่องได้โดยไม่ทำให้ประวัติเหตุการณ์ในอดีตหลุดหรือพังทลายครับ

4 ทำไมฟิลด์ `metadata` ในตาราง `device_events` ต้องใช้ชนิด `JSONB`?

ตอบ: เป็นการใช้สถาปัตยกรรมแบบ Hybrid Relational-Document Model ครับ ข้อมูลสำคัญที่ต้อง Search/Sort เช่น เวลาและสถานะ เราแยกเป็นคอลัมน์มาตรฐาน ส่วนข้อมูลเทคนิคเซนเซอร์เรดาร์ (เช่น พิกัด X, Y, Z, Signal Quality, ความเร็ว) เราเก็บลง `JSONB` ซึ่งใน PostgreSQL เป็น Binary Format ที่สามารถทำ Index ค้นหาข้างในได้ และรองรับการต่อยอดเซนเซอร์รุ่นใหม่ในอนาคตโดยไม่ต้องรัน Migration แก้โครงสร้างตาราง

5 ทำไมต้องเปิดใช้ Soft Delete (`deleted_at`) ในทุกตาราง?

ตอบ: เพื่อปฏิบัติตามมาตรฐาน Healthcare & Safety Compliance ครับ ในระบบแจ้งเหตุฉุกเฉินและโรงพยาบาล ข้อมูลการเกิดอุบัติเหตุห้ามสูญหายเด็ดขาด หากผู้ดูแลเผลอกดลบห้องน้ำหรืออาคาร การลบแบบ Hard Delete จะทำให้ประวัติคนล้มในอดีตถูกล้างทิ้งไปด้วย Soft Delete จะซ่อนข้อมูลจากหน้าจอปกติ แต่ยังคงข้อมูลจริงไว้ในดิสก์เพื่อใช้เป็นหลักฐานทางการแพทย์และคดีความได้เสมอครับ

6 ทำไมเลือกใช้ PostgreSQL บน Azure Flexible Server แทน SQLite หรือ NoSQL?

ตอบ: SQLite ไม่รองรับ Concurrency การเขียนพร้อมกันจากอุปกรณ์นับร้อย และไม่รองรับการทำงานแบบคลาวด์ ส่วน NoSQL (เช่น MongoDB) ขาดการตรวจสอบ Referential Integrity (Foreign Key) ที่เข้มงวด PostgreSQL เป็น Relational DB ที่สมบูรณ์แบบ มีคุณสมบัติ ACID แท้จริง รองรับ JSONB และบน Azure Flexible Server ยังบังคับใช้ SSL Mode Require เข้ารหัสข้อมูลระหว่างส่ง 100% ป้องกันการดักดมข้อมูลในเครือข่ายครับ

#### วงจรชีวิตของสถานะเหตุการณ์ (Event Status Lifecycle & Clinical Triage)

1. pending (รอดำเนินการ)

เกิดขึ้นทันทีเมื่อเกิดเหตุ fall หรือ prolonged_stay

ส่งเสียงไซเรนบนเว็บ + แจ้งเตือนเข้า LINE

2. resolved (เข้าช่วยเหลือแล้ว)

เจ้าหน้าที่เข้าถึงตัวผู้ป่วยแล้วกด "รับทราบ/บันทึกผล"

บันทึก resolved_at, resolved_by และ note ลง DB

หรือ

3. false_alarm (แจ้งเตือนผิดพลาด)

เกิดจากสิ่งของตกหล่นหรือผู้ใช้ทดสอบระบบ

ตัดออกจากสถิติอัตราการล้มจริงของหอพัก/โรงพยาบาล

7

## การทำงานของระบบหลังบ้าน (Go Backend Engine & Concurrency)

สถาปัตยกรรม Goroutines, Channel-based WebSockets Hub และการแจ้งเตือน LINE

ระบบหลังบ้านถูกพัฒนาด้วย ภาษา Go (Golang) และ Gin Web Framework ข้อได้เปรียบสูงสุดคือการจัดการ Concurrency ด้วย Goroutines ที่ใช้หน่วยความจำเพียงไม่กี่กิโลไบต์ต่อ Thread ทำให้สามารถรองรับสัญญาณจากห้องน้ำนับพันห้องพร้อมกันบนเครื่องสเปกประหยัด (Azure VM B1s 1 vCPU, 1 GB RAM) ได้อย่างลื่นไหล

โค้ดหลัก backend/internal/service/service.go : ProcessEvent Go Routine Concurrency

func (s *Service) ProcessEvent(devID, evType, name, val, meta string) error {
    // 1. ตรวจสอบว่าถ้าเป็น fall หรือ prolonged_stay ให้ตั้งสถานะเป็น "pending" เพื่อรอคนช่วย
    status := "normal"
    if name == "fall" || name == "prolonged_stay" {
        status = "pending"
    }

    // 2. บันทึกเหตุการณ์ลงตาราง device_events
    event := iot.DeviceEvent{
        DeviceID: dev.ID,
        Type:     evType,
        Name:     name,
        Value:    val,
        Metadata: meta,
        Status:   status,
    }
    s.db.Create(&event)

    // 3. ยิงแจ้งเตือน LINE แบบ Asynchronous (Goroutine) เพื่อไม่บล็อกการตอบสนอง
    if name == "fall" {
        msg := fmt.Sprintf("🚨 [แจ้งเตือนเหตุฉุกเฉิน: ตรวจพบคนหกล้ม!]\n📍 อาคาร: %s\n🚪 ห้อง: %s", group.Name, dev.Name)
        for _, cfg := range configs {
            go notifier.SendLineNotification(cfg.Type, cfg.LineToken, cfg.LineGroupID, msg)
        }
    } else if name == "prolonged_stay" {
        msg := fmt.Sprintf("⏳ [แจ้งเตือน: เข้าห้องน้ำนานเกินกำหนด]\n📍 อาคาร: %s\n🚪 ห้อง: %s", group.Name, dev.Name)
        for _, cfg := range configs {
            go notifier.SendLineNotification(cfg.Type, cfg.LineToken, cfg.LineGroupID, msg)
        }
    }

    // 4. กระจายข้อมูลสดเข้า WebSocket Hub ไปยังทุกหน้าจอของเจ้าหน้าที่
    s.hub.Broadcast(wsPayload)
    return nil
}

8

## การทำงานของระบบหน้าบ้าน (Next.js 14 Dashboard & Audio Alert)

สถาปัตยกรรม React Hook, การสังเคราะห์เสียงไซเรนผ่าน Web Audio API และผังห้องน้ำ Real-time

#### WebSocket Client Hook

ในไฟล์ frontend/src/hooks/useDashboard.ts เชื่อมต่อผ่าน wss://fall-detection.sopon-project.me/ws มีระบบ Exponential Backoff Auto-Reconnect หากเครือข่ายหลุด จะทำการ Reconnect อัตโนมัติทุก 3, 6, 12 วินาที พร้อมดึง State ล่าสุดมา Sync ใหม่ทันทีที่เน็ตกลับมา

#### HTML5 Web Audio API Siren

เพื่อไม่ต้องพึ่งพาไฟล์ MP3 ภายนอกที่อาจโหลดไม่ขึ้น ระบบใช้ AudioContext Oscillator ในการสังเคราะห์คลื่นเสียงความถี่ไซเรน (Sawtooth wave สลับ 600Hz - 900Hz) จากเบราว์เซอร์โดยตรง ปลุกเตือนพยาบาลและเจ้าหน้าที่ได้ทันทีแม้อยู่หน้าจออื่น

#### เส้นทางหน้าเว็บ (Frontend Routes Structure):

/ (Root)

ผังภาพรวม Live Dashboard

การ์ดสถานะห้องน้ำทุกห้องสดๆ

/buildings

ผังแยกตามอาคาร/ชั้น

รองรับการสเกลหลายตึก

/history

บันทึกประวัติและผลลัพธ์

ฟิลเตอร์เหตุการณ์, Export, Audit

/settings

ตั้งค่าระบบและ LINE

ปรับเกณฑ์เซนเซอร์, จัดการ Token

9

## สถาปัตยกรรมคลาวด์และการดีพลอย (Cloud Architecture & Docker)

การบริหารทรัพยากรบน Azure VM B1s, Docker Containerization และ Nginx Reverse Proxy SSL

#### สเปกคลาวด์ Azure VM (Ubuntu)

- • VM Size: Standard B1s (1 vCPU, 1.0 GiB RAM)
- • Swap File: 4.0 GiB (ป้องกันแรมเต็ม OOM Crash)
- • Domain: fall-detection.sopon-project.me
- • SSL Certificate: Let's Encrypt Certbot (HTTPS)

#### คอนเทนเนอร์ Docker บนเซิร์ฟเวอร์

- • prod_mqtt_broker: Mosquitto (Port 1883)
- • prod_go_backend: Go REST + WS (Port 8080)
- • prod_nextjs_frontend: Next.js Standalone (Port 3000)
- • Network: proxy-network (เชื่อมกับ Nginx กลาง)

ขั้นตอนการอัปเดตระบบขึ้น Azure Cloud (Production Deployment Workflow): Azure Container Registry (ACR)

# 1. คอมไพล์ Docker Image ในเครื่อง Local
docker build -t soponproject.azurecr.io/fall-detection-backend:latest ./backend
docker build -t soponproject.azurecr.io/fall-detection-frontend:latest ./frontend

# 2. Push Image เข้าสู่ Azure Container Registry
docker push soponproject.azurecr.io/fall-detection-backend:latest
docker push soponproject.azurecr.io/fall-detection-frontend:latest

# 3. SSH สู่ Azure VM เพื่อ Pull และรีสตาร์ทระบบแบบ Zero-Downtime
ssh azureuser@sopon-project.me "cd ~/fall-detection && docker compose pull && docker compose up -d"

## คลังคำถาม-คำตอบเพื่อการสอบจบ (Master Defense Q&A Cheat Sheet)

10 คำถามยอดฮิตที่คณะกรรมการมักจะถาม พร้อมคำอธิบายเชิงวิศวกรรมที่ถูกต้องและน่าเชื่อถือที่สุด

1 ทำไมถึงเลือกใช้เรดาร์คลื่นมิลลิเมตร (mmWave) แทนการใช้กล้อง AI หรือเซนเซอร์อื่นๆ?

แนวทางตอบ: ห้องน้ำเป็นพื้นที่ส่วนบุคคลสูงสุด มีข้อจำกัดทางกฎหมายคุ้มครองข้อมูลส่วนบุคคล (PDPA/Privacy Law) ที่ห้ามติดตั้งกล้องถ่ายภาพทุกชนิด ส่วนเซนเซอร์อินฟราเรด (PIR) ตรวจจับได้เฉพาะการขยับตัว หากผู้สูงอายุล้มหมดสติหรือนอนนิ่ง PIR จะเข้าใจว่าห้องว่าง อีกทั้งความชื้นและไอฝ้าจากฝักบัวยังบดบังเซนเซอร์แสง เรดาร์คลื่นมิลลิเมตรจึงเป็นคำตอบที่สมบูรณ์แบบที่สุด เพราะส่งคลื่นสะท้อนวัตถุ ไม่สร้างภาพถ่าย ทำงานได้แม้ในที่มืดสนิท (0 Lux) และทะลุละอองน้ำไอน้ำได้ 100% ครับ

2 ทำไมต้องใช้เรดาร์ 2 ตัว (LD6002C 60GHz และ LD2410C 24GHz) ทำไมไม่ใช้ตัวเดียวเพื่อประหยัดต้นทุน?

แนวทางตอบ: เพื่อทำ Sensor Fusion ข้ามย่านความถี่ แก้ปัญหา False Alarm ครับ เรดาร์ 60GHz มีความแม่นยำสูงมากในการจับพลวัตการตกกระทบ (Impact Velocity) แต่มักสับสนเมื่อมีสิ่งของ เช่น ขวดแชมพูหรือผ้าเช็ดตัวขนาดใหญ่ร่วงหล่น การนำเรดาร์ 24GHz (LD2410C) มาทำหน้าที่เป็น Empty Room Guard จะช่วยยืนยันว่ามีมนุษย์อยู่ในห้องจริงก่อนที่จะยอมรับเหตุการณ์ล้ม ทำให้ระบบไม่เกิด False Alarm รบกวนเจ้าหน้าที่ และ LD2410C ยังจับการหายใจของคนหมดสติได้นิ่งกว่าด้วยครับ

3 ถ้าเกิดไฟดับ สายไฟหลุด หรือตัวบอร์ดพัง ระบบจะทราบได้อย่างไรว่ากล่องนั้น "ออฟไลน์" ในเมื่อเครื่องดับไปแล้ว?

แนวทางตอบ: เราใช้มาตรฐานสากลของ IoT คือ MQTT Last Will and Testament (LWT หรือพินัยกรรม) ครับ ตอนที่ตัวบอร์ดเชื่อมต่อเน็ตเข้ากับ Broker จะฝากข้อความพินัยกรรม {"name":"offline"} ไว้ล่วงหน้า หากบอร์ดดับกะทันหันจนสัญญาณขาดหายไปโดยไม่บอกลา ตัวโบรกเกอร์ (Mosquitto) จะเป็นผู้เปิดพินัยกรรมและส่งข้อความ offline ให้กับระบบหลังบ้านแทนตัวบอร์ดทันที หน้าจอแดชบอร์ดจึงเปลี่ยนสถานะเป็นการ์ดสีเทาได้ทันทีโดยไม่ต้องรอครับ

4 ถ้าผู้สูงอายุแค่ขับถ่ายนาน หรือท้องผูก ระบบจะส่งเสียงไซเรนดังลั่นทำให้เขาตกใจหรืออับอายหรือไม่?

แนวทางตอบ: ไม่ดังครับ! ระบบของเราแยกลำดับความรุนแรงของเหตุการณ์ชัดเจน:

- คนล้มฉุกเฉิน (fall): ไซเรนจะเปิดทันทีเพื่อขอความช่วยเหลือเร่งด่วน
- อยู่นานเกินกำหนด (prolonged_stay): ไซเรนจะ ไม่ทำงานเด็ดขาด (Silent Alert) แต่จะแสดงไฟสีส้มที่ตัวเครื่อง และส่งข้อความเงียบเข้า LINE ของผู้ดูแล เพื่อให้พยาบาลเดินมาเคาะประตูถามไถ่อย่างสุภาพ ไม่ละเมิดศักดิ์ศรีและไม่สร้างความตกใจให้ผู้สูงอายุครับ

5 ถ้าระบบติดตั้งในโรงพยาบาลหรือคอนโดที่มี 50 - 100 ห้องน้ำ เซิร์ฟเวอร์จะรับโหลดไหวไหม ข้อมูลจะชนกันหรือไม่?

แนวทางตอบ: รับได้สบายมากครับ เพราะระบบถูกออกแบบด้วยสถาปัตยกรรม Microservices:

1. MQTT Protocol: เป็น Publish/Subscribe ที่เบามาก แพ็กเก็ตมีขนาดเล็กระดับร้อยไบต์ โบรกเกอร์ Mosquitto รับ Concurrency ได้ระดับหมื่นอุปกรณ์พร้อมกัน
2. ภาษา Go (Golang): ใช้ Goroutine ในการประมวลผล แต่ละ Thread ใช้หน่วยความจำเพียง 2 KB สามารถรับส่งข้อมูลแบบ Non-blocking
3. เราได้สร้างหน้าจำลอง simulator/index.html ที่สามารถยิง Stress Test จำลองอุปกรณ์พร้อมกันหลายๆ ห้องส่งขึ้น Azure Cloud ได้แบบสดๆ ให้กรรมการชมได้ครับ

6 ถ้าผู้สูงอายุสะดุดล้ม แต่สามารถพยุงตัวลุกขึ้นยืนเองได้ ระบบจะจัดการอย่างไร?

แนวทางตอบ: เรามีฟังก์ชัน Fall Auto-Recovery ในเฟิร์มแวร์ครับ เมื่อเกิดเหตุล้ม ระบบจะยังจับตาดูความสูงและพิกัด หากพบว่าเป้าหมายสามารถลุกขึ้นมายืนทรงตัวในระดับความสูงปกติได้ต่อเนื่องเกิน 2.5 วินาที ตัวบอร์ดจะยกเลิกสถานะล้ม ปิดเสียงไซเรน และปรับสถานะกลับมาเป็น enter (กำลังใช้งาน) โดยอัตโนมัติ ไม่รบกวนหน่วยกู้ชีพครับ

7 หากขนาดห้องน้ำหรือความสูงเพดานแต่ละห้องไม่เท่ากัน จะต้องแก้โค้ดและแกะกล่องมาแฟลชใหม่ทีละกล่องหรือไม่?

แนวทางตอบ: ไม่ต้องครับ เราทำระบบ Remote Configuration ผ่านหน้า Web Dashboard ไว้ ผู้ดูแลสามารถกดตั้งค่าความสูงเพดาน (Mount Height), ความกว้างยาวห้อง และเวลาอยู่นานเกิน ผ่านหน้าเว็บได้เลย ข้อมูลจะวิ่งผ่าน MQTT เข้าสู่บอร์ด และบันทึกลง NVS Flash Memory ของ ESP32 อัตโนมัติ แม้ไฟดับค่าคอนฟิกก็ไม่หายครับ

8 ถ้าอินเทอร์เน็ตของอาคารล่ม หรือ Wi-Fi ขาดหาย ตัวอุปกรณ์ยังสามารถช่วยชีวิตคนได้อยู่หรือไม่?

แนวทางตอบ: ยังทำงานได้ในระดับ Local ครับ เพราะระบบออกแบบสถาปัตยกรรมแบบ Edge Computing สมองกลและตรรกะการตรวจจับการล้มทำงานอยู่บนตัวชิป ESP32-S3 โดยตรง หากเน็ตตัด ไซเรนแจ้งเตือนฉุกเฉินและไฟกะพริบสีแดงหน้าห้องน้ำยังคงทำงานได้อย่างสมบูรณ์เพื่อแจ้งคนบริเวณใกล้เคียง และเมื่อเน็ตกลับมาต่อติด บอร์ดจะส่งข้อมูลย้อนหลังขึ้นสู่เซิร์ฟเวอร์ครับ

9 การบันทึกประวัติ (History Log) มีประโยชน์อย่างไรในทางการแพทย์ และมีขั้นตอนจัดการอย่างไร?

แนวทางตอบ: มีประโยชน์อย่างมากในด้าน Clinical Audit & Response Time ครับ ระบบบันทึกเวลาที่เกิดเหตุ (Triggered Time), เวลาที่เจ้าหน้าที่เข้าถึงตัว (Resolved Time), ผู้เข้าช่วยเหลือ (Resolved By) และบันทึกอาการ (Note) ข้อมูลนี้ช่วยให้แพทย์ทราบว่าคนไข้นอนหมดสตินานกี่นาทีเพื่อวินิจฉัยภาวะกล้ามเนื้อสลาย (Rhabdomyolysis) และช่วยให้ผู้บริหารตรวจสอบ KPI เวลาการเข้าช่วยของเวรพยาบาลได้ครับ

10 โครงสร้างระบบมีความปลอดภัยทางไซเบอร์ (Cybersecurity) อย่างไรบ้าง?

แนวทางตอบ: เราออกแบบความปลอดภัยระดับ Enterprise:

1. การเชื่อมต่อเว็บและ WebSocket ทั้งหมดผ่าน HTTPS/WSS เข้ารหัส TLS/SSL ด้วยใบรับรอง Let's Encrypt
2. ฐานข้อมูล PostgreSQL บน Azure บังคับใช้การเชื่อมต่อแบบ SSL Mode Require และปิดพอร์ตไม่ให้คนภายนอกเข้าโดยตรง
3. รหัสผ่านผู้ดูแลระบบถูกเข้ารหัสด้วย Bcrypt Hash พร้อม Salt ไม่มีทางถอดรหัสเป็นข้อความธรรมดาได้
4. ระบบรันบน Docker Private Network ปิดกั้นพอร์ตที่ไม่จำเป็นทั้งหมดครับ

SafeBathroom IoT • โครงการวิจัยและพัฒนาระบบตรวจจับการล้มอัจฉริยะในห้องน้ำ

Created for Final Project Defense & Architectural Reference • SafeBathroom IoT Project
