SoponSaenkaew/fall-detection/Guide/sensors_guide.html

Official Manufacturer Documentation: Shenzhen Hi-Link Electronic Co., Ltd.

# คู่มือเจาะลึกเซนเซอร์เรดาร์คู่ HLK-LD6002C & HLK-LD2410C Technical Citations

รวบรวมหลักการทำงาน FMCW, ข้อกำหนดทางไฟฟ้า, สถาปัตยกรรมชิป, โปรโตคอลสื่อสาร UART, การวิเคราะห์คลื่นรบกวน (ม่าน/ละอองน้ำ), และการเชื่อมโยงกับโค้ด ESP32-S3 พร้อม การอ้างอิงตรงจากคู่มือทางการทุกจุด (หน้า, บรรทัด, หัวข้อ, และข้อความต้นฉบับภาษาอังกฤษ) เพื่อใช้สอบจบปริญญานิพนธ์

ESC เพื่อล้าง

เรดาร์ตรวจจับการล้ม

HLK-LD6002C

60 GHz FMCW | 2T2R Antenna

เรดาร์ตรวจคนเข้า-ออก

HLK-LD2410C

24 GHz FMCW | 8 Distance Gates

เกณฑ์ไฟเลี้ยง & Ripple

3.3V / Ripple ≤50mV

Current ≥ 1A | DCDC ≥ 2MHz

สภาพแวดล้อมออกแบบ

Bathroom Only

Single Person Scenario

ตารางเปรียบเทียบ 2 เซนเซอร์ HLK-LD6002C (60 GHz) HLK-LD2410C (24 GHz) Sensor Fusion Architecture เจาะลึก ม่าน & น้ำในห้องน้ำ สารบัญอ้างอิงทั้งหมด (Citations Directory)

Architectural Overview

## เปรียบเทียบสถาปัตยกรรมและคุณสมบัติทางเทคนิค 2 เซนเซอร์

สรุปข้อมูลเชิงเปรียบเทียบระหว่าง HLK-LD6002C และ HLK-LD2410C พร้อมบทบาทหน้าที่ในระบบ SafeBathroom IoT

พารามิเตอร์ | HLK-LD6002C (เรดาร์ตรวจจับล้ม) | HLK-LD2410C (เรดาร์ตรวจจับคน) | แหล่งอ้างอิงคู่มือ
ย่านความถี่ (Operating Frequency) | 58 GHz – 62 GHz (ย่าน 60 GHz) | 24 GHz – 24.25 GHz (ISM Band) | LD6002C P.3 L.10 LD2410C P.17 L.7
หลักการมอดูเลต (Modulation) | FMCW (Frequency-Modulated Continuous Wave) | FMCW (Frequency-Modulated Continuous Wave) | LD6002C P.3 L.7 LD2410C P.3 L.6
ชิปประมวลผลหลัก (Core Chipset) | ADT6101P + ARM® Cortex®-M3 (ประมวลผล 3D Point Cloud ภายใน) | Hi-Link Custom DSP + BLE SoC (จับการขยับทรวงอก Micro-motion) | LD6002C P.3 L.4-5
สายอากาศ (Antenna Topology) | 2T2R Microstrip (2 Transmit, 2 Receive) | 1T1R Microstrip Patch Antenna | LD6002C P.3 L.5
มุมตรวจจับ (Beamwidth / FOV) | แนวนอน ±60°, แนวตั้ง ±60° (กรวยกว้าง 120°) | แนวนอน ±60°, แนวตั้ง ±60° | LD6002C P.4 T.4.3 LD2410C P.4 L.8
ระยะและความละเอียด (Range & Resolution) | รัศมีตรวจจับ $R = 2.0$ ม. (ติดตั้งสูง 2.2 - 3.0 ม.) | ระยะตรวจจับสูงสุด 5.0 - 6.0 ม. (ความละเอียด Gate ละ 0.75 ม.) | LD6002C P.8 L.5 LD2410C P.3 L.13
แรงดันและกระแสไฟ (Electrical Specs) | 3.1V - 3.5V (Typ 3.3V) | ≥ 1A | Ripple ≤ 50mV | 5.0V (Typ) | ≥ 200mA (เฉลี่ย 79 mA) | LD6002C P.9 L.7-8 LD2410C P.17 L.9
การเชื่อมต่อกับ ESP32-S3 (Interface Pins) | UART Serial (ESP32 RX18 ← TX0, TX17 → RX0) | GPIO Digital OUT (ESP32 Pin 16) | LD6002C P.4 T.5.2 LD2410C P.7 T.4.2
สภาพแวดล้อมที่ออกแบบเฉพาะ (Target Scenario) | Bathroom Scenario, Single Person Only | Indoor Human Presence & Micro-motion | LD6002C P.9 L.10 LD2410C P.3 L.11
บทบาทในระบบ SafeBathroom IoT | ตัดสินและยืนยันเหตุการณ์ "คนล้มในห้องน้ำ (Fall Event)" | ควบคุมสถานะ "เข้าห้องน้ำ (Enter)", "ห้องว่าง (Exit)", และป้องกัน False Alarm | RadarSensors.h

60 GHz mmWave Radar

## HLK-LD6002C: เซนเซอร์เรดาร์ตรวจจับการล้ม 60 GHz Fall Detection Core

วิเคราะห์หลักการทำงาน FMCW, ข้อกำหนดทางไฟฟ้า, และโปรโตคอลสื่อสาร UART Type 0x0E02 / 0x0E0E

### สถาปัตยกรรมและหลักการทำงาน FMCW

LD6002C P.3 L.4-11

HLK-LD6002C พัฒนาขึ้นบนชิปเซ็ตเรดาร์ ADT6101P รวมระบบ RF Transceiver ย่านความถี่ 57–64 GHz, สายอากาศไมโครสตริปแบบ 2T2R, หน่วยความจำ Flash 1MB, และแกนประมวลผล ARM® Cortex®-M3 ไว้บนโมดูลขนาดเพียง 25 × 23 มม.

วงจรประมวลผลสัญญาณ FMCW:

โมดูลส่งคลื่นมิลลิเมตรแบบปรับความถี่ต่อเนื่อง (Chirp Signal) ย่าน 58–62 GHz เมื่อคลื่นตกกระทบร่างกายมนุษย์และสะท้อนกลับ จะถูกนำมาผสมกับสัญญาณส่งเพื่อสกัดความถี่บีต (Beat Frequency) จากนั้น ARM Cortex-M3 จะทำการประมวลผล 2D-FFT เพื่อคำนวณระยะทาง ($R$), ความเร็ว Doppler ($v$), และมุมตกกระทบ ($AoA$) ทั้งแนวราบและแนวดิ่ง (±60°) เพื่อสร้าง 3D Centroid Height Tracking

"Suitable for ceiling installation, single person scenarios in small areas of bathrooms and bathrooms." — คู่มือหน้า 3 บรรทัดที่ 10–11

### ข้อกำหนดแหล่งจ่ายไฟที่เข้มงวดมาก

LD6002C P.9 L.7-9

ในหน้า 9 หัวข้อ Section 7: Precautions ข้อ 2 ระบุเตือนอย่างหนักแน่นว่า เรดาร์ย่าน 60 GHz ไวต่อสัญญาณรบกวนของไฟเลี้ยงสูงมาก:

แรงดันใช้งาน (Operating Voltage)

3.1V – 3.5V

Typical 3.3V (ห้ามเกิน 3.6V)

กระแสไฟที่ต้องการ (Current Capacity)

≥ 1.0 A (1000mA)

กินไฟปกติ 600mA, พีค 1A

Power Ripple จำกัดสูงสุด: ≤ 50 mV

หากใช้ DC-DC Switching Regulator ต้องเลือกความถี่สวิตชิ่ง ≥ 2 MHz เพื่อป้องกันสัญญาณสวิตชิ่งความถี่ต่ำรั่วเข้าสู่ภาครับเรดาร์

### โปรโตคอลการสื่อสาร UART และโครงสร้างเฟรม (Communication Protocol)

Baudrate: 115200, 8-N-1 (อ้างอิงจาก HLK-LD6002C Fall detection Communication protocol.pdf)

Protocol P.3 L.3-15

Standard Frame Format (Binary Packet):

SOF (1B)

0x01

ID (2B)

idH | idL

LEN (2B)

lenH | lenL

TYPE (2B)

0x0E02 / 0E0E

HEAD_CKSUM

~XOR (Byte 0-6)

DATA (Payload $N$ Bytes)

Fall Flag / Target Height

DATA_CKSUM

~XOR (Data)

Type 0x0E02 Protocol P.4 L.3

Fall Alarm Reporting Frame

Payload 1 Byte: 0x01 = ตรวจพบล้ม (Fall), 0x00 = สภาวะปกติ (Normal)

Type 0x0E0E Protocol P.5 L.20

Target Height Reporting Frame

Payload 4 Bytes: IEEE 754 Single Precision Float แสดงค่าความสูงของเป้าหมายสดระดับมิลลิเมตร (เมตร)

Type 0x0E0C Protocol P.5 L.3

Set Room Boundaries (ขอบเขตห้อง)

Payload 16 Bytes: กำหนด 4 floats ($X_L, X_R, Z_F, Z_B$) เพื่อตีกรอบพื้นที่ห้องน้ำและตัดสัญญาณรบกวนนอกกรอบ

### ข้อกำหนดการออกแบบกล่องหุ้มเรดาร์ (Section 8: Radome Design)

LD6002C P.9-10 Sec 8

เนื่องจากคลื่นย่าน 60 GHz มีความยาวคลื่นในอากาศเพียง $\lambda = \frac{c}{f} = \frac{3 \times 10^8}{60 \times 10^9} \approx 5.0\text{ mm}$ การออกแบบกล่องพิมพ์ 3 มิติต้องปฏิบัติตามสูตรฟิสิกส์คลื่นสะท้อน:

ระยะห่างเสาอากาศถึงผิวด้านในกล่อง:
d = (c / 2f) × N = 2.5 mm × N
โดย N = 1, 2, 3... (ระยะที่เหมาะสมคือ 2.5 มม. หรือ 5.0 มม.)

วัสดุที่ผู้ผลิตแนะนำ (Dielectric Constant ต่ำ):

- ABS: $\varepsilon_r = 2.0 - 3.5$, $\tan\delta = 0.005 - 0.019$ (แนะนำสำหรับงาน 3D Print)
- PTFE (Teflon): $\varepsilon_r = 2.0$, $\tan\delta < 0.0002$ (ดีเยี่ยมที่สุด)
- PC / Plexiglass: $\varepsilon_r = 2.6 - 2.9$, ผิวเรียบหนาสม่ำเสมอ
- ห้ามใช้วัสดุที่มีโลหะหรือสารเคลือบฟอยล์ผสมเด็ดขาด

24 GHz Human Presence Radar

## HLK-LD2410C: เซนเซอร์เรดาร์ตรวจจับการมีอยู่ของบุคคล 24 GHz Presence Gatekeeper

วิเคราะห์หลักการตรวจจับ Micro-motion จากการหายใจ, ระบบ Gate ละ 0.75 เมตร, และคำเตือนเรื่องผ้าม่าน

### ตรวจจับความเคลื่อนไหวระดับเสี้ยวคลื่น (Micro-motion)

LD2410C P.3 L.4-14

HLK-LD2410C อาศัยคลื่น FMCW ย่าน 24 GHz เพื่อจำแนกสภาวะมนุษย์ออกเป็น 2 ระดับอย่างอิสระ:

Motion State

ตรวจจับการก้าวเดิน, การเอื้อมมือ, หรือการเปลี่ยนอิริยาบถขนาดใหญ่

Stationary State

ตรวจจับการกระเพื่อมของทรวงอกจากการหายใจแม้นั่งนิ่งอยู่บนโถสุขภัณฑ์

โครงสร้างช่วงระยะตรวจจับ (Distance Gates): LD2410C P.8 L.23

ตัวเรดาร์แบ่งระยะตรวจจับออกเป็น 8 Distance Gates โดยแต่ละ Gate มีความกว้างคงที่ 0.75 เมตร (Gate 0 = 0–0.75m, Gate 1 = 0.75–1.5m ... Gate 8 = 6.0m) ซึ่งสามารถปรับตั้งค่าความไว (Sensitivity 0–100) แยกแต่ละ Gate ได้อย่างอิสระ

### คำเตือนสิ่งรบกวน (Section 5.5: Installation Conditions)

LD2410C P.12 Sec 5.5

ในคู่มือหน้า 12 มีการเตือนถึงปัจจัยแวดล้อมที่จะทำให้เรดาร์ทำงานเพี้ยนอย่างชัดเจน:

วัตถุที่แกว่งไกวต่อเนื่อง (Continuously Moving Objects):

"Non-human objects that are continuously moving in the sensing area, such as animals, continuously swinging curtains, large green plants facing the air outlet, etc."

คลื่นสะท้อนทะลุด้านหลัง (Back Lobe):

คลื่น 24 GHz สามารถทะลุทะลวงด้านหลังบอร์ดได้ หากด้านหลังมีสายไฟสั่นไหวหรือมีหนูวิ่งในฝ้าเพดาน ผู้ผลิตแนะนำให้ติด Metal shield / Metal backplane ไว้ด้านหลังเพื่อบล็อก Back Lobe

### แผนผังจำลอง Distance Gates (0.75m Resolution) และจุดที่ม่านกระทบ

Resolution: 0.75m / Gate

Gate 0

0–0.75m

หน้าเซนเซอร์

Gate 1

0.75–1.5m

คนยืน/อาบน้ำ

Gate 2

1.5–2.25m

โถสุขภัณฑ์

Gate 3

2.25–3.0m

ขอบเขตห้องน้ำ

Gate 4 ⚠️

3.0–3.75m

ตำแหน่งม่าน!

Gate 5

3.75–4.5m

นอกห้อง

Gate 6

4.5–5.25m

นอกห้อง

Gate 7-8

5.25–6.0m

ระยะสูงสุด

💡 วิธีแก้ปัญหาม่านผ่าน Bluetooth App (HLKRadarTool): สามารถตั้งค่า Max Detection Gate = 3 (2.25–3.0 เมตร) เพื่อสั่งให้เรดาร์หยุดสแกนและเพิกเฉยต่อสัญญาณคลื่นที่สะท้อนมาจาก Gate 4 ขึ้นไป ซึ่งเป็นตำแหน่งที่ม่านหน้าต่างตั้งอยู่ได้อย่างสมบูรณ์แบบ!

Multi-Sensor Fusion

## กลไก Sensor Fusion และการเชื่อมโยงกับโค้ดบน ESP32-S3

ทำไมต้องใช้ 2 เซนเซอร์คู่กัน? และโค้ดใน RadarSensors.h ทำงานร่วมกันอย่างไร

ปัญหาถ้าใช้ LD6002C เดี่ยวๆ

หากไม่มี LD2410C คอยเป็น Gatekeeper วันใดที่มีผ้าขนหนูตกจากราว ไม้กวาดล้ม หรือสิ่งของหล่นลงพื้นตอนไม่มีคนในห้อง เรดาร์ 60 GHz อาจตรวจจับการเคลื่อนที่ตกลงพื้นและยิงแจ้งเตือน False Fall Alert ส่ง LINE ปลุกญาติกลางดึกได้

ปัญหาถ้าใช้ LD2410C เดี่ยวๆ

LD2410C สามารถบอกได้เพียงว่า "มีคนหรือไม่มีคน" (Occupied / Empty) แต่ไม่สามารถวัดความสูงของร่างกาย หรือวิเคราะห์ความเร่งของการทิ้งตัวลงสู่พื้นได้ จึงไม่สามารถทำหน้าที่ตรวจจับการล้มได้เลย

การผสานพลัง (Sensor Fusion)

ระบบใช้ LD2410C เฝ้าประตูห้องน้ำ เมื่อมีคนเข้าห้อง (current_event != "exit") จึงจะ "ปลดล็อกให้อัลกอริทึมล้มของ LD6002C ทำงาน" หากห้องว่าง สัญญาณล้มจะถูกกรองทิ้ง 100% ป้องกัน False Alarm ได้เด็ดขาด

### โค้ด Sensor Fusion ใน RadarSensors.h (บรรทัดที่ 145–177)

board-esp32s3/board/RadarSensors.h

// 1. เฟรมตรวจจับการล้มจาก LD6002C (Type 0x0E02)
if (msgType == 0x0E02) {
  uint8_t is_fall = payload[0]; // 0x01 = ล้ม, 0x00 = ปกติ

  if (is_fall == 0x01) {
    // ⭐ ตรรกะ Sensor Fusion: ประมวลผลล้มเฉพาะเมื่อ LD2410C ยืนยันว่ามีคนอยู่ในห้อง
    if (current_event != "exit") {
      if (!fall_alerted_this_session && current_event != "fall") {
        if (!is_falling_candidate) {
          is_falling_candidate = true;
          fall_start_time = millis();
        } else if (millis() - fall_start_time >= fall_confirmation_delay) {
          current_event = "fall";
          sendEvent("event", "fall", "ตรวจพบคนล้ม (เรดาร์)");
        }
      }
    } else {
      target_event = "exit"; // ห้องว่าง -> กรองสัญญาณทิ้ง ไม่ส่ง False Alarm!
    }
  }
}

Environmental Dynamics

## เจาะลึกกรณีศึกษา: ม่านกันแสงแนวตั้ง และน้ำในห้องน้ำ

ข้อเท็จจริงทางฟิสิกส์คลื่นแม่เหล็กไฟฟ้า ตอบคำถามทำไมม่านทำให้เพี้ยน และทำไมน้ำฝักบัวถึงไม่รบกวน

Case Study 1

### ปัญหาม่านกันแสงแนวตั้ง (Vertical Blackout Blinds) ทำให้เซนเซอร์เพี้ยน

LD2410C P.12 L.13

กลไกการเกิดความผิดเพี้ยน:

- Doppler จากการแกว่งไกว: แถบม่านแนวตั้งทิ้งตัวอิสระจากเพดานถึงพื้น เมื่อลมแอร์หรือพัดลมดูดอากาศพัด แถบม่านจะสะบัด (Flutter) เกิดคลื่น Doppler ความถี่ต่ำระดับมิลลิเมตร ซึ่งตรงกับช่วงความถี่การหายใจของมนุษย์ ทำให้ LD2410C ค้างสถานะ OCCUPIED ตลอดเวลา
- พื้นที่สะท้อนคลื่นมหึมา (High RCS): ม่านกันแสงมักเคลือบสารทึบแสงหนา แผ่น PVC หรือมีชั้นฟอยล์กันความร้อน ซึ่งสะท้อนคลื่นวิทยุได้แรงมาก เสมือนกระจกเงาคลื่นวิทยุ บดบังสัญญาณสะท้อนจากมนุษย์
- Point Cloud หลอกการล้มใน LD6002C: ม่านพาดจากเพดาน ($Z=2.5\text{m}$) ลงมาถึงพื้น ($Z=0\text{m}$) เมื่อม่านสะบัด จุดสะท้อนจะรูดจากบนลงล่าง อัลกอริทึมใน LD6002C จึงคิดว่า "มีคนทิ้งตัวลงสู่พื้นอย่างรวดเร็ว = คนล้ม!"

แนวทางแก้ไข 3 ระดับที่ได้ผลจริง:

1. การแก้ไขทางกายภาพ (ได้ผลทันที): ตรึงชายม่านด้านล่างเข้ากับวงกบหน้าต่างด้วยแม่เหล็ก หรือเทป ไม่ให้แถบม่านพริ้วไหวตามลม หรือปรับทิศทางบานสวิงแอร์ไม่ให้เป่าปะทะม่าน
2. การปรับจูน Gate ใน LD2410C: ใช้แอปมือถือ HLKRadarTool กำหนด Max Detection Gate ให้หยุดก่อนถึงระยะม่าน หรือลดค่า Sensitivity ใน Gate ที่ตรงกับม่าน
3. การปรับหน่วงเวลายืนยันล้มในโค้ด: ปรับแก้ค่า fall_confirmation_delay ใน SystemConfig.h จากเดิม 0 มิลลิวินาที ให้เป็น 2000 - 3000 ms (หน่วง 2–3 วินาที) เพื่อกรองสัญญาณสะบัดชั่วคราวทิ้ง

Case Study 2

### น้ำจากฝักบัว และน้ำในอ่างอาบน้ำ รบกวนเซนเซอร์หรือไม่?

LD6002C P.9 L.10

น้ำในอ่าง / น้ำขังบนพื้น

ไม่รบกวน 100% (ปลอดภัย)

น้ำนิ่งถือเป็นวัตถุอยู่นิ่ง (Static Object) อัลกอริทึม Static Clutter Removal ของทั้งสองเซนเซอร์จะมองเป็นพื้นผิวสะท้อนคลื่นเหมือนแผ่นกระเบื้องเรียบๆ และตัดทิ้งไปโดยสิ้นเชิง

น้ำจากฝักบัวขณะเปิดอาบ

ไม่หลอกว่าล้ม & ตรงกับสภาพจริง

ละอองน้ำเป็นเม็ดเล็กๆ กระจัดกระจาย ค่าพลังงานสะท้อน (RCS) ต่ำมาก ไม่สามารถรวมตัวเป็นก้อนมนุษย์ (Cluster) และไม่มีการทิ้งตัวลงไปนอนนิ่งค้างที่พื้น อีกทั้งขณะเปิดฝักบัวย่อมมีคนอาบน้ำอยู่จริง สถานะ Enter จึงถูกต้องสมบูรณ์

ข้อควรระวังเดียวเรื่องน้ำ

หยดน้ำเกาะหน้ากล่องเรดาร์

โมเลกุลของน้ำดูดกลืนคลื่น 60 GHz สูง หากติดตั้งกล่องเซนเซอร์ในจุดที่น้ำจากฝักบัวกระเด็นใส่จนเกิดหยดน้ำเกาะหนาเตอะที่หน้ากล่อง จะลดทอนระยะตรวจจับลง จึงควรติดตั้งบนเพดานกึ่งกลางห้องให้พ้นแนวน้ำกระเซ็น

Verification Directory

## สารบัญอ้างอิงตรงจากคู่มือทางการทุกจุด (Citations Directory)

ตารางระบุ หน้า, บรรทัด, หัวข้อ, และข้อความต้นฉบับภาษาอังกฤษ พร้อมคำแปลภาษาไทย

รวม 15 รายการอ้างอิง

รหัสอ้างอิง | เอกสารทางการ | ตำแหน่ง (หน้า/บรรทัด) | หัวข้อในเอกสาร | ข้อความต้นฉบับภาษาอังกฤษ (Original English) & คำแปล

LD6002C P.3 L.4-11

### หัวข้อการอ้างอิง

ข้อความต้นฉบับจากคู่มือ (Original English):

Quote text...

คำแปลเชิงวิชาการภาษาไทย:

Thai translation...

การนำไปประยุกต์ใช้ในโปรเจกต์นี้:

Project context...

ปิดหน้าต่าง (Close)

SafeBathroom IoT System • Sopon Saenkaew (RMUTI Khon Kaen) • Millimeter-Wave Radar Fall Detection Project

เอกสารอ้างอิงนี้จัดทำขึ้นโดยตรวจสอบความถูกต้องตรงกับคู่มือทางการของ Shenzhen Hi-Link Electronic Co., Ltd. ทุกฉบับ
