SoponSaenkaew/fall-detection/docs/compare_toc.py

import pymupdf as fitz
import re

pdf_path = r"D:\Final project\fall-detection\docs\เอกสารประกอบโปรเจกต์จบ\รายงานเชิงเทคนิก\รายงานเชิงเทคนิค_final_render.pdf"
doc = fitz.open(pdf_path)

def get_doc_page_str(pdf_idx): # 0-indexed
    p = pdf_idx + 1
    if p == 1:
        return "ปกนอก"
    elif p <= 13:
        thai = ["ก", "ข", "ค", "ง", "จ", "ฉ", "ช", "ซ", "ฌ", "ญ", "ฎ", "ฏ", "ฐ"]
        return thai[p - 2]
    else:
        return str(p - 13)

print("=== 1. VERIFYING LIST OF TABLES (สารบัญตาราง) ===")
# Expected tables:
# ตารางที่ 2.1
# ตารางที่ 2.2
# ตารางที่ 2.3
# ตารางที่ 3.1
# ตารางที่ 4.1
# ตารางที่ 4.2
tables = [
    "ตารางที่ 2.1",
    "ตารางที่ 2.2",
    "ตารางที่ 2.3",
    "ตารางที่ 3.1",
    "ตารางที่ 4.1",
    "ตารางที่ 4.2"
]

for t in tables:
    found = []
    for i, page in enumerate(doc):
        # don't search in front matter (p < 14)
        if i < 13:
            continue
        txt = page.get_text()
        if t in txt:
            found.append((i+1, get_doc_page_str(i)))
    print(f"{t}: Actual document page = {found}")

print("\n=== 2. VERIFYING LIST OF FIGURES (สารบัญรูป) ===")
figures = [
    "รูปที่ 2.1", "รูปที่ 2.2", "รูปที่ 2.3", "รูปที่ 2.4", "รูปที่ 2.5", "รูปที่ 2.6",
    "รูปที่ 3.1", "รูปที่ 3.2", "รูปที่ 3.3", "รูปที่ 3.4", "รูปที่ 3.5", "รูปที่ 3.6", "รูปที่ 3.7", "รูปที่ 3.8",
    "รูปที่ 4.1", "รูปที่ 4.2", "รูปที่ 4.3", "รูปที่ 4.4", "รูปที่ 4.5"
]

for f in figures:
    found = []
    for i, page in enumerate(doc):
        if i < 13:
            continue
        txt = page.get_text()
        if f in txt:
            found.append((i+1, get_doc_page_str(i)))
    print(f"{f}: Actual document page = {found}")

print("\n=== 3. VERIFYING TABLE OF CONTENTS (สารบัญ) HEADINGS ===")
headings = [
    ("บทที่ 1  บทนำ", "บทที่ 1"),
    ("1.1  ความเป็นมาและความสำคัญของปัญหา", "1.1 ความเป็นมา"),
    ("1.2  วัตถุประสงค์ของโครงงาน", "1.2 วัตถุประสงค์"),
    ("1.3  ขอบเขตของโครงงาน", "1.3 ขอบเขต"),
    ("1.4  ประโยชน์ที่คาดว่าจะได้รับ", "1.4 ประโยชน์"),
    ("1.5  นิยามศัพท์เฉพาะ", "1.5 นิยามศัพท์"),
    ("1.6  ตัวแปรที่ศึกษา", "1.6 ตัวแปรที่ศึกษา"),
    ("บทที่ 2  ทฤษฎีและงานวิจัยที่เกี่ยวข้อง", "บทที่ 2"),
    ("2.1  ทฤษฎีเรดาร์คลื่นมิลลิเมตร", "2.1 ทฤษฎีเรดาร์"),
    ("2.2  โมดูลเรดาร์คลื่นมิลลิเมตร 60 GHz", "2.2 โมดูลเรดาร์"),
    ("2.3  โมดูลเรดาร์ตรวจจับบุคคล 24 GHz", "2.3 โมดูลเรดาร์"),
    ("2.4  ไมโครคอนโทรลเลอร์ ESP32-S3", "2.4 ไมโครคอนโทรลเลอร์"),
    ("2.5  โปรโตคอลการสื่อสาร MQTT", "2.5 โปรโตคอล"),
    ("2.6  ระบบบริการคลาวด์และสถาปัตยกรรมเว็บ", "2.6 ระบบบริการคลาวด์"),
    ("2.7  งานวิจัยและเอกสารที่เกี่ยวข้อง", "2.7 งานวิจัย"),
    ("บทที่ 3  วิธีดำเนินงาน", "บทที่ 3"),
    ("3.1  ขั้นตอนและแผนการดำเนินงานวิจัย", "3.1 ขั้นตอน"),
    ("3.2  การวิเคราะห์และออกแบบสถาปัตยกรรมระบบรวม", "3.2 การวิเคราะห์"),
    ("3.3  การออกแบบและพัฒนาฮาร์ดแวร์", "3.3 การออกแบบและพัฒนาฮาร์ดแวร์"),
    ("3.4  การพัฒนาเฟิร์มแวร์ระบบสมองกลฝังตัว", "3.4 การพัฒนาเฟิร์มแวร์"),
    ("3.5  การพัฒนาระบบคลาวด์และบริการหลังบ้าน", "3.5 การพัฒนาระบบคลาวด์"),
    ("3.6  การพัฒนาเว็บแอปพลิเคชันส่วนแสดงผลแดชบอร์ด", "3.6 การพัฒนาเว็บ"),
    ("3.7  การออกแบบการทดสอบและเกณฑ์การประเมินผลระบบ", "3.7 การออกแบบการทดสอบ"),
    ("บทที่ 4  ผลการดำเนินงาน", "บทที่ 4"),
    ("4.1  ผลการออกแบบและสร้างแผ่นวงจรพิมพ์ฮาร์ดแวร์", "4.1 ผลการออกแบบ"),
    ("4.2  ผลการพัฒนาเฟิร์มแวร์ระบบสมองกลฝังตัวและการทำงานของเรดาร์", "4.2 ผลการพัฒนาเฟิร์มแวร์"),
    ("4.3  ผลการพัฒนาระบบบริการหลังบ้านและระบบแจ้งเตือน Webhook", "4.3 ผลการพัฒนาระบบบริการหลังบ้าน"),
    ("4.4  ผลการพัฒนาเว็บแอปพลิเคชันส่วนแสดงผลแดชบอร์ด", "4.4 ผลการพัฒนาเว็บ"),
    ("4.5  ผลการทดสอบและประเมินประสิทธิภาพของระบบ", "4.5 ผลการทดสอบ"),
    ("บทที่ 5  สรุปผล และข้อเสนอแนะ", "บทที่ 5"),
    ("5.1  สรุปผลการดำเนินงาน", "5.1 สรุปผล"),
    ("5.2  ปัญหาและอุปสรรคในการดำเนินงาน", "5.2 ปัญหาและอุปสรรค"),
    ("5.3  ข้อเสนอแนะสำหรับการพัฒนาต่อยอดในอนาคต", "5.3 ข้อเสนอแนะ"),
    ("บรรณานุกรม", "บรรณานุกรม"),
    ("ภาคผนวก ก", "ภาคผนวก ก"),
    ("ภาคผนวก ข", "ภาคผนวก ข"),
    ("ภาคผนวก ค", "ภาคผนวก ค"),
    ("ภาคผนวก ง", "ภาคผนวก ง"),
    ("ประวัติผู้เขียน", "ประวัติผู้เขียน"),
]

for label, query in headings:
    found = []
    for i, page in enumerate(doc):
        if i < 13:
            continue
        txt = page.get_text()
        if query in txt:
            found.append((i+1, get_doc_page_str(i)))
    print(f"{label:55s}: Actual page = {found}")
