SoponSaenkaew/fall-detection/docs/find_heading_pages.py

import fitz
import re

pdf_path = r"D:\Final project\fall-detection\docs\เอกสารประกอบโปรเจกต์จบ\รายงานเชิงเทคนิก\รายงานเชิงเทคนิค_final_render.pdf"
doc = fitz.open(pdf_path)

# Let's map every page in PDF to its header page number
page_map = {}
for i, page in enumerate(doc):
    txt = page.get_text()
    lines = [l.strip() for l in txt.split('\n') if l.strip()]
    
    # check first line or top block
    header_num = None
    if lines:
        first = lines[0]
        # is first line a page number?
        if re.match(r"^(\d+|[ก-ฮ])$", first):
            header_num = first
    page_map[i + 1] = {
        "header": header_num,
        "first_lines": lines[:3]
    }

# Let's search for actual headings in the PDF
headings_to_find = [
    ("บทคัดย่อภาษาไทย", r"บทคัดย่อ\s*$"),
    ("Abstract", r"Abstract\s*$"),
    ("กิตติกรรมประกาศ", r"กิตติกรรมประกาศ"),
    ("สารบัญ", r"สารบัญ\s*$"),
    ("สารบัญตาราง", r"สารบัญตาราง"),
    ("สารบัญรูป", r"สารบัญรูป"),
    ("คำอธิบายสัญลักษณ์และคำย่อ", r"คำอธิบายสัญลักษณ์และคำย่อ"),
    ("บทที่ 1  บทนำ", r"บทที่ 1"),
    ("1.1  ความเป็นมา", r"1\.1\s+ความเป็นมา"),
    ("1.2  วัตถุประสงค์", r"1\.2\s+วัตถุประสงค์"),
    ("1.3  ขอบเขต", r"1\.3\s+ขอบเขต"),
    ("1.4  ประโยชน์", r"1\.4\s+ประโยชน์"),
    ("1.5  นิยามศัพท์", r"1\.5\s+นิยามศัพท์"),
    ("1.6  ตัวแปรที่ศึกษา", r"1\.6\s+ตัวแปรที่ศึกษา"),
    ("บทที่ 2  ทฤษฎีและงานวิจัยที่เกี่ยวข้อง", r"บทที่ 2"),
    ("2.1  ทฤษฎีเรดาร์คลื่นมิลลิเมตร", r"2\.1\s+ทฤษฎีเรดาร์"),
    ("2.2  โมดูลเรดาร์ 60 GHz", r"2\.2\s+โมดูลเรดาร์.*60"),
    ("2.3  โมดูลเรดาร์ 24 GHz", r"2\.3\s+โมดูลเรดาร์.*24"),
    ("2.4  ไมโครคอนโทรลเลอร์ ESP32-S3", r"2\.4\s+ไมโครคอนโทรลเลอร์"),
    ("2.5  โปรโตคอล MQTT", r"2\.5\s+โปรโตคอล"),
    ("2.6  ระบบบริการคลาวด์", r"2\.6\s+ระบบบริการคลาวด์"),
    ("2.7  งานวิจัยและเอกสารที่เกี่ยวข้อง", r"2\.7\s+งานวิจัย"),
    ("บทที่ 3  วิธีดำเนินงาน", r"บทที่ 3"),
    ("3.1  ขั้นตอนและแผนการดำเนินงานวิจัย", r"3\.1\s+ขั้นตอน"),
    ("3.2  การวิเคราะห์และออกแบบสถาปัตยกรรมระบบรวม", r"3\.2\s+การวิเคราะห์"),
    ("3.3  การออกแบบและพัฒนาฮาร์ดแวร์", r"3\.3\s+การออกแบบ.*ฮาร์ดแวร์"),
    ("3.4  การพัฒนาเฟิร์มแวร์", r"3\.4\s+การพัฒนาเฟิร์มแวร์"),
    ("3.5  การพัฒนาระบบคลาวด์", r"3\.5\s+การพัฒนาระบบคลาวด์"),
    ("3.6  การพัฒนาเว็บแอปพลิเคชัน", r"3\.6\s+การพัฒนาเว็บแอปพลิเคชัน"),
    ("3.7  การออกแบบการทดสอบ", r"3\.7\s+การออกแบบการทดสอบ"),
    ("บทที่ 4  ผลการดำเนินงาน", r"บทที่ 4"),
    ("4.1  ผลการออกแบบและสร้างแผ่นวงจรพิมพ์", r"4\.1\s+ผลการออกแบบ"),
    ("4.2  ผลการพัฒนาเฟิร์มแวร์", r"4\.2\s+ผลการพัฒนาเฟิร์มแวร์"),
    ("4.3  ผลการพัฒนาระบบบริการหลังบ้าน", r"4\.3\s+ผลการพัฒนา.*หลังบ้าน"),
    ("4.4  ผลการพัฒนาเว็บแอปพลิเคชัน", r"4\.4\s+ผลการพัฒนาเว็บแอปพลิเคชัน"),
    ("4.5  ผลการทดสอบและประเมินประสิทธิภาพ", r"4\.5\s+ผลการทดสอบ"),
    ("บทที่ 5  สรุปผล และข้อเสนอแนะ", r"บทที่ 5"),
    ("5.1  สรุปผลการดำเนินงาน", r"5\.1\s+สรุปผล"),
    ("5.2  ปัญหาและอุปสรรค", r"5\.2\s+ปัญหาและอุปสรรค"),
    ("5.3  ข้อเสนอแนะ", r"5\.3\s+ข้อเสนอแนะ"),
    ("บรรณานุกรม", r"บรรณานุกรม"),
    ("ภาคผนวก ก", r"ภาคผนวก ก"),
    ("ภาคผนวก ข", r"ภาคผนวก ข"),
    ("ภาคผนวก ค", r"ภาคผนวก ค"),
    ("ภาคผนวก ง", r"ภาคผนวก ง"),
    ("ประวัติผู้เขียน", r"ประวัติผู้เขียน")
]

print("=== ACTUAL PAGES OF HEADINGS IN PDF ===")
for title, pat in headings_to_find:
    found_pages = []
    for i, page in enumerate(doc):
        txt = page.get_text()
        if re.search(pat, txt):
            # check body page number
            hnum = page_map[i+1]['header']
            found_pages.append((i+1, hnum))
    print(f"{title:45s} -> Found on PDF P.{[p[0] for p in found_pages]} (Body page num: {[p[1] for p in found_pages]})")
