SoponSaenkaew/fall-detection/docs/check_ch1_ch2.py

import pymupdf as fitz
import re

pdf_path = r"D:\Final project\fall-detection\docs\เอกสารประกอบโปรเจกต์จบ\รายงานเชิงเทคนิก\รายงานเชิงเทคนิค_final_render.pdf"
doc = fitz.open(pdf_path)

def get_page(pdf_idx):
    p = pdf_idx + 1
    if p <= 13:
        return ["ปกนอก", "ก", "ข", "ค", "ง", "จ", "ฉ", "ช", "ซ", "ฌ", "ญ", "ฎ", "ฏ"][p-1]
    return str(p - 13)

items = [
    # Chapter 1
    ("1.1  ความเป็นมาและความสำคัญของปัญหา", r"1\.1\s+ความเป็นมา"),
    ("1.2  วัตถุประสงค์ของโครงงาน", r"1\.2\s+วัตถุประสงค์"),
    ("1.3  สมมติฐานของโครงงาน", r"1\.3\s+สมมติฐาน"),
    ("1.4  ข้อตกลงเบื้องต้น", r"1\.4\s+ข้อตกลง"),
    ("1.5  ขอบเขตของโครงงาน", r"1\.5\s+ขอบเขต"),
    ("1.6  ตัวแปรที่ศึกษา", r"1\.6\s+ตัวแปร"),
    ("1.7  ประโยชน์ที่คาดว่าจะได้รับ", r"1\.7\s+ประโยชน์"),
    ("1.8  คำนิยามศัพท์เฉพาะ", r"1\.8\s+คำนิยามศัพท์|1\.8\s+นิยามศัพท์"),
    # Chapter 2
    ("2.1  เทคโนโลยีเรดาร์คลื่นมิลลิเมตร", r"2\.1\s+เทคโนโลยีเรดาร์|2\.1\s+ทฤษฎีเรดาร์"),
    ("2.2  โมดูลเรดาร์ตรวจจับการหกล้ม", r"2\.2\s+โมดูลเรดาร์"),
    ("2.3  สถาปัตยกรรมไมโครคอนโทรลเลอร์ ESP32-S3", r"2\.3\s+สถาปัตยกรรม|2\.3\s+โมดูลเรดาร์ตรวจจับบุคคล"),
    ("2.4  สถาปัตยกรรมและโปรโตคอลการสื่อสารข้อมูล IoT", r"2\.4\s+สถาปัตยกรรม|2\.4\s+ไมโครคอนโทรลเลอร์"),
    ("2.5  ระบบบริการหลังบ้านและการจัดการฐานข้อมูล", r"2\.5\s+ระบบบริการ|2\.5\s+โปรโตคอล"),
    ("2.6  ระบบส่วนแสดงผลหน้าบ้านสำหรับผู้ใช้งาน", r"2\.6\s+ระบบส่วนแสดงผล|2\.6\s+ระบบบริการคลาวด์"),
    ("2.7  งานวิจัยและเอกสารที่เกี่ยวข้อง", r"2\.7\s+งานวิจัย"),
]

for label, pat in items:
    found = []
    for i in range(13, 33):
        txt = doc[i].get_text()
        if re.search(pat, txt):
            found.append((i+1, get_page(i)))
    print(f"{label:50s} -> Found at {found}")
