SoponSaenkaew/fall-detection/(commit log)

2026-03-29 feat: device and group
2026-03-29 init: group and device schema
2026-03-29 merge: group and device schema
2026-03-29 fix: service and handler's device
2026-03-31 feat: dashboard/ add and delete group or device
2026-03-31 feat: edit config device
2026-04-01 add: device simulate
2026-07-05 feat: ปรับปรุงระบบเป็นรุ่น Demo No-Auth, เพิ่มหน้าจอติดตามรายอาคาร และระบบจำลองผังห้อง 2D
2026-08-12 refactor: update README with Azure deployment info, simplify seed device IDs, and restructure ESP32 board directory
2026-08-27 docs: อัปเดตเอกสารอธิบายโครงการระบบตรวจจับการล้มอัจฉริยะฉบับสมบูรณ์ (README & docs)
2026-09-19 fix(experiment): restore logTerminal container, wire OTA form submit, and add live radar packet logging
2026-09-20 refactor(ld6002c): rely strictly on UART 0x0E02 and TX2 digital pin for fall detection, retaining height for debug only
2026-09-20 feat(ld6002c): add manual impact moment button and radar detection latency tracking with CSV export
2026-09-20 fix(csv): add UTF-8 BOM and expand scenario buffer for Thai language support in Excel
2026-09-23 fix(led): fix green status LED not staying on during normal radar operation
2026-09-23 fix(led): completely remove offline blue LED override, ensuring solid green in normal operation
2026-09-25 feat: implement prolonged stay alert, SafeBathroom rebranding, and comprehensive system guide
    - Firmware: add prolonged stay silent alert (orange LED, no siren) and NVS persistence
    - Backend: add StayTimeoutMinutes setting, event handling, and LINE notifications
    - Frontend: rebrand to SafeBathroom IoT, add history event audit resolution, settings modal
    - Docs & Guide: add standalone project guide with hardware pinouts, LD6002C protocols, PostgreSQL ER schemas, and ADRs
    - Tooling: add multi-device simulator for live demonstration
2026-10-14 feat: enhance UI with Prompt font, add device settings validation, and update technical report docs
